ICST-AHMI/TPadTablet_design/pics/P4113149_C3.jpg

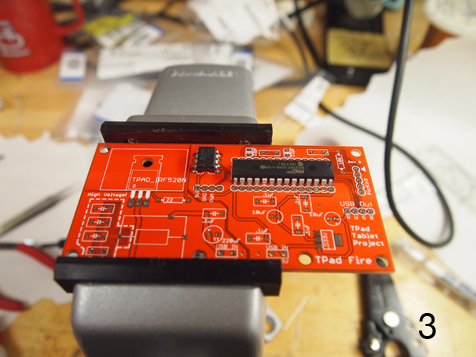
pics/P4113149_C3.jpg
