ICST-AHMI/TPadTablet_design/pics/P4113161_C14.jpg

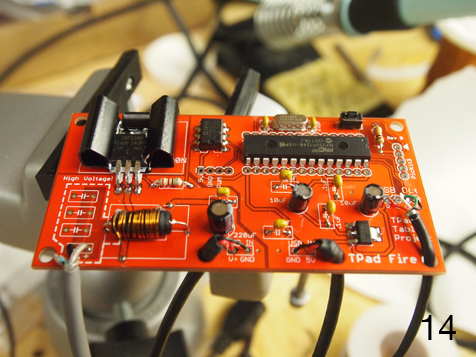
pics/P4113161_C14.jpg
