ICST-AHMI/TPadTablet_design/pics/first_C1.jpg

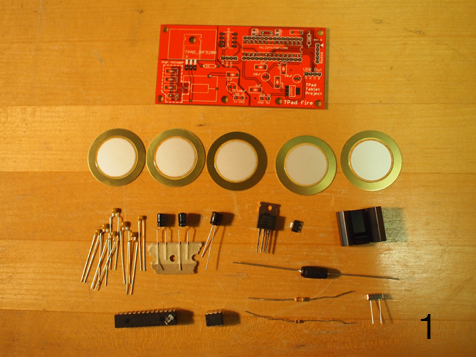
pics/first_C1.jpg
