ICST-AHMI/TPadTablet_design/pics/P4113148_C2.jpg

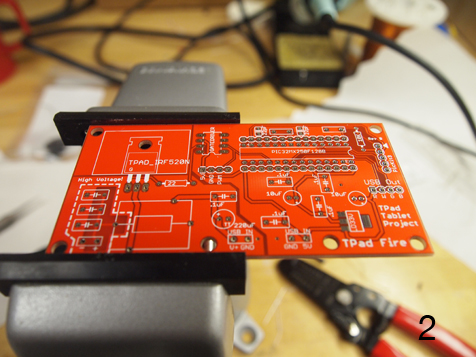
pics/P4113148_C2.jpg
