ICST-AHMI/TPadTablet_design/pics/P4113150_C4.jpg

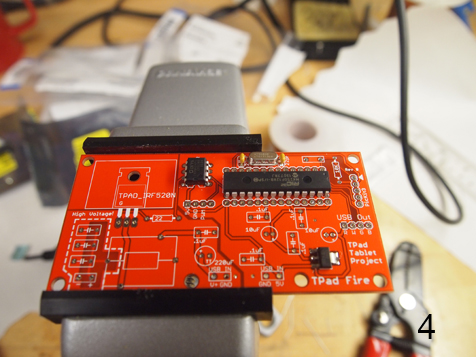
pics/P4113150_C4.jpg
