ICST-AHMI/TPadTablet_design/pics/P4113151_C5.jpg

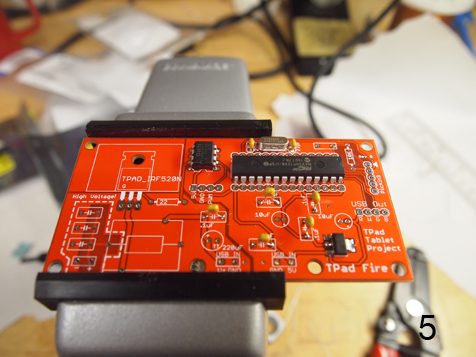
pics/P4113151_C5.jpg
