ICST-AHMI/TPadTablet_design/pics/P4113152_C6.jpg

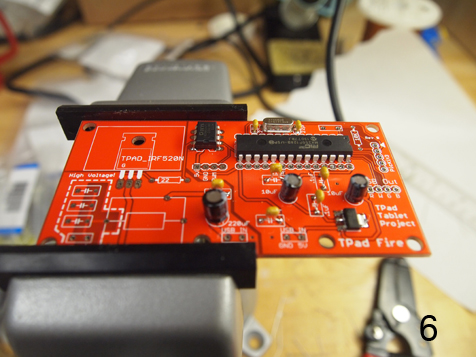
pics/P4113152_C6.jpg
