ICST-AHMI/TPadTablet_design/pics/P4113153_C7.jpg

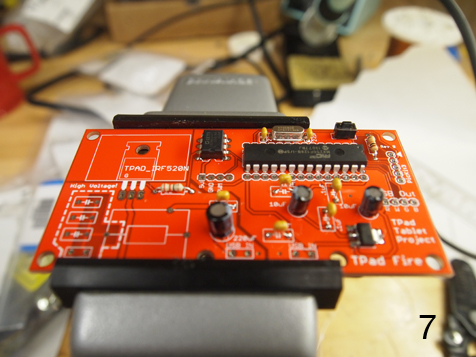
pics/P4113153_C7.jpg
