ICST-AHMI/TPadTablet_design/pics/P4113154_C8.jpg

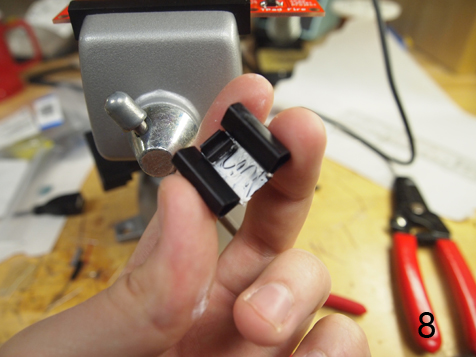
pics/P4113154_C8.jpg
