ICST-AHMI/TPadTablet_design/pics/P4113155_C9.jpg

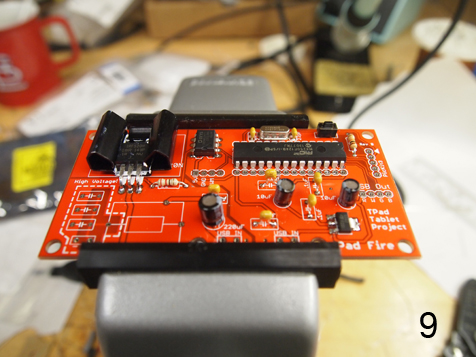
pics/P4113155_C9.jpg
