ICST-AHMI/TPadTablet_design/pics/P4113156_C10.jpg

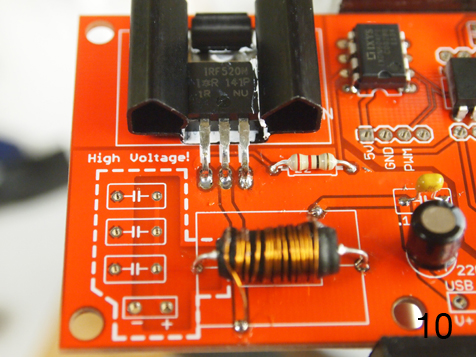
pics/P4113156_C10.jpg
