ICST-AHMI/TPadTablet_design/pics/P4113158_C11.jpg

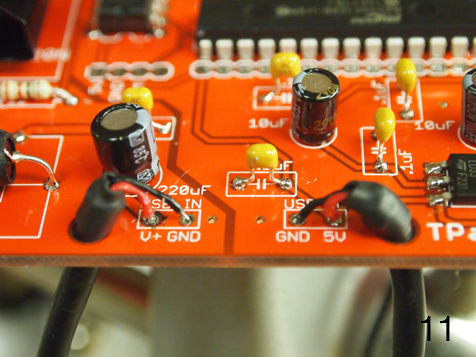
pics/P4113158_C11.jpg
