ICST-AHMI/TPadTablet_design/pics/P4113159_C12.jpg

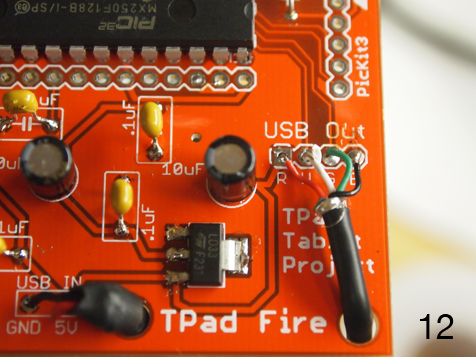
pics/P4113159_C12.jpg
