ICST-AHMI/TPadTablet_design/pics/P4113160_C13.jpg

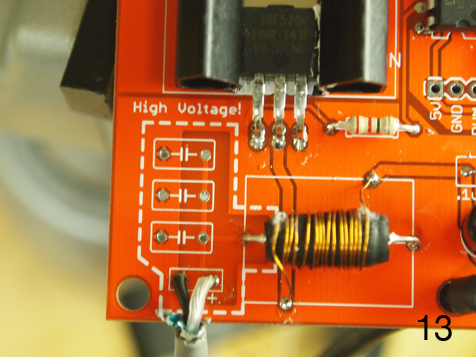
pics/P4113160_C13.jpg
