ICST-AHMI/TPadTablet_design/pics/P4113184_A1_1.jpg

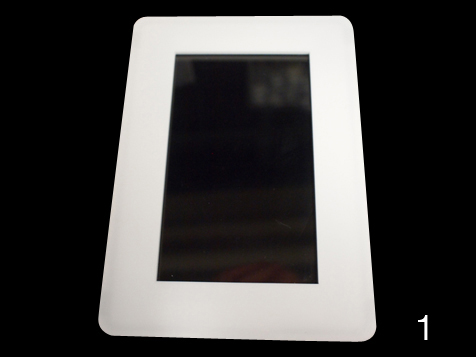
pics/P4113184_A1_1.jpg
