ICST-AHMI/TPadTablet_design/pics/P4113187_A2.jpg

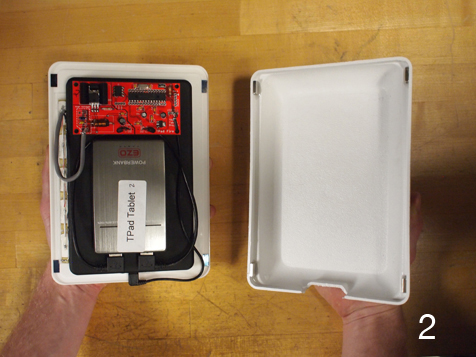
pics/P4113187_A2.jpg
