ICST-AHMI/TPadTablet_design/pics/P4113188_A3.jpg

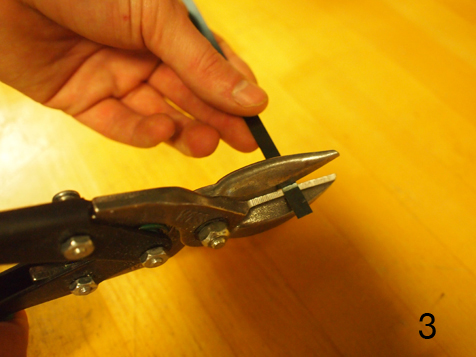
pics/P4113188_A3.jpg
