ICST-AHMI/TPadTablet_design/pics/P4113190_A4.jpg

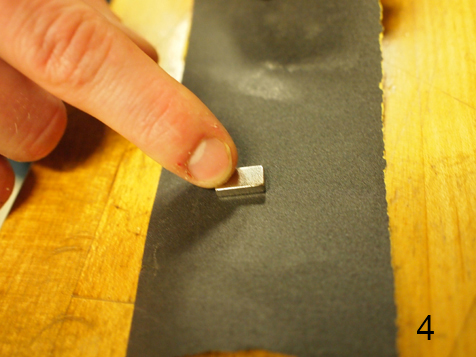
pics/P4113190_A4.jpg
