ICST-AHMI/TPadTablet_design/pics/P4113191_A6.jpg

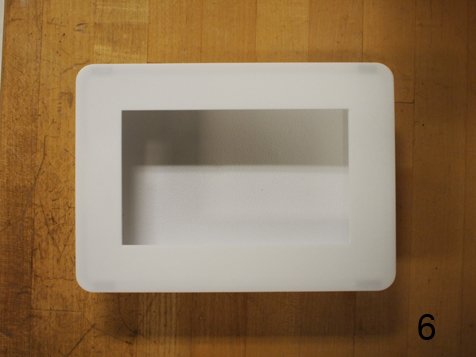
pics/P4113191_A6.jpg
