ICST-AHMI/TPadTablet_design/pics/P4113192_A5.jpg

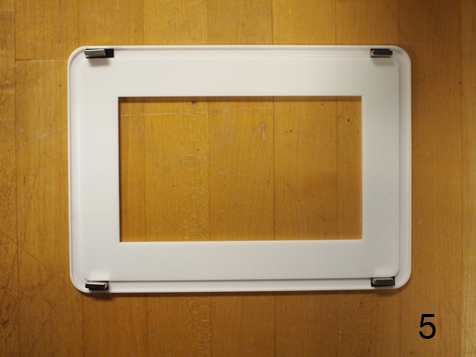
pics/P4113192_A5.jpg
