ICST-AHMI/TPadTablet_design/eagle/_export/bom/Bill of Materials - Electronics - 2.1.xlsx

Name (Description) | Ref Des | Manufacturer | Manufacturer P/N | Distributor | Qty | Price | Extended Price
LED SMARTLED GREEN 570NM 0603 | LED2 |  | LG L29K-G2J1-24-Z | Digi | 1 | 0.22 | 0.22
LED ORANGE 606NM 0603 SMD | LED1 |  | LO L29K-J2L1-24-Z | Digi | 1 | 0.21 | 0.21
LED SMARTLED RED 630NM 0603 SMD | LED3 |  | LS L29K-H1J2-1-Z | Digi | 1 | 0.21 | 0.21
IC LI-ION/LI-POLY CTRLR 10MSOP | U1 | Microchip | MCP73833-AMI/UN | Digi | 1 | 1.02 | 1.02
RES 330 OHM 1/8W 1% SMD 0603 | R1,R2,R3 | Vishay | MCT06030C3300FP500 | Digi | 3 | 0.08 | 0.24
RES 1.0K OHM 1/8W 5% 0805 SMD | R4 | Yageo | RC0805JR-071KL | Digi | 1 | 0.1 | 0.1
RES 10K OHM 1/10W 5% 0603 SMD | 3 | Samsung | RC1608J103CS | Digi | 1 | 0.1 | 0.1
RES 10K OHM 1/8W 5% 0805 SMD | R5 | Yageo | RC0805JR-0710KL | Digi | 1 | 0.1 | 0.1
CAP CER 10UF 10V 10% X5R 0805 | C1,C2 | Yageo | CC0805ZKY5V6BB106 | Digi | 2 | 0.19 | 0.38
CONN USB MICRO B RECPT SMT R/A | J2 | FCI | 10118193-0001LF | Digi | 1 | 0.46 | 0.46
IC DVR LOW SIDE OMINIFET SOT-223 | U2 | STM | VNL5050N3TR-E | Digi | 1 | 1.69 | 1.69
SW SLIDE DPDT 6VDC 0.3A PCMNT | S1 | C&K | JS202011CQN | Digi | 1 | 0.39 | 0.39
Li-Polymer 3.7V 5800mAh W/ PCB&Wires |  | Tenergy | 30130 | AllBattery | 1 | 27.5 | 27.5
CONN HEADER 2POS 4.2MM R/A TIN | J1 | Molex | 39300020 | Digi | 1 | 0.77 | 0.77
 |  |  |  |  |  | total | 32.62
DIODE SCHOTTKY 35V 8A POWERDI5 | D1 | Diodes, Inc | PDS835L-13 | Digi | 1 | 1.44 | 1.44
INDUCTOR POWER .82UH 19.0A SMD | L1 | Vishay Dale | IHLP3232DZERR82M01 | Digi | 1 | 1.48 | 1.48
MOSFET P-CH 20V 60A 8-SON | Q2 | TI | CSD25401Q3 | Digi | 1 | 1.32 | 1.32
MOSFET N-CH 25V 60A 8SON | Q1 | TI | CSD16340Q3 | Digi | 1 | 1.26 | 1.26
IC REG CTRLR PWN VM 16-TSSOP | U3 | TI | TPS43000PW | Digi | 1 | 6.13 | 6.13
RES 4.7 OHM 1/10W 5% 0603 SMD | R8, R9 | Yageo | RC0603JR-074R7L | Digi | 2 | 0.1 | 0.2
RES 10K OHM 1/10W 5% 0603 SMD | R11 | Samsung | RC1608J103CS | Digi | 1 | 0.1 | 0.1
RES 17.8K OHM 1/10W 1% 0603 SMD | R13 | Yageo | RC0603FR-0717K8L | Digi | 1 | 0.1 | 0.1
RES 19.1K OHM 1/10W 1% 0603 SMD | R12 | Yageo | RC0603FR-0719K1L | Digi | 1 | 0.1 | 0.1
RES 63.4K OHM 1/10W 1% 0603 SMD | R14 | Yageo | RC0603FR-0763K4L | Digi | 1 | 0.1 | 0.1
RES 100K OHM 1/10W 5% 0603 SMD | R10 | Yageo | RC0603JR-07100KL | Digi | 1 | 0.1 | 0.1
RES 1.0K OHM 1/10W 5% 0603 SMD | R7 | Yageo | RC0603JR-071KL | Digi | 1 | 0.1 | 0.1
CAP TANT 330UF 6.3V 20% 2917 | C4,C5 | Panasonic | 6TPE330ML | Digi | 2 | 2.03 | 4.06
CAP CER 47UF 10V Y5V 1210 | C6,C7 | TDK | C3225Y5V1A476Z | Digi | 2 | 0.94 | 1.88
CAP CER 10UF 10V Y5V 0805 | C8 | Yageo | CC0805ZKY5V6BB106 | Digi | 1 | 0.16 | 0.16
CAP CER 4700PF 50V 10% X7R 0603 | C3,C9 | TDK | C1608X7R1H472K | Digi | 2 | 0.1 | 0.2
CAP CER 0.47UF 10V 10% X5R 0603 | C10,C11,C12 | TDK | C1608X5R1A474K080AA | Digi | 3 | 0.1 | 0.3
CAP CER 220PF 50V 5% NP0 0603 | C13 | Samsung | CL10C221JB8NCNC | Digi | 1 | 0.1 | 0.1
CAP CER 1500PF 50V 10% X7R 0603 | C14 | Samsung | CL10B152KB8SFNC | Digi | 1 | 0.1 | 0.1
CAP CER 27PF 50V 5% NP0 0603 | C15 | Samsung | CL10C270JB8NNNC | Digi | 1 | 0.1 | 0.1
CAP CER 2.2UF 6.3V Y5V 0603 |  | Yageo | CC0603ZRY5V5BB225 | Digi | 4 | 0.11 | 0.44
 |  |  |  |  |  | total | 19.77
CONN PLUG USB 4POS RT ANG PCB | J4 | Molex | 480370001 | Digi | 1 | 1.19 | 1.19
CONN POWER JACK 2.1MM PCB | J3 | CUI | PJ-202A | Digi | 1 | 0.92 | 0.92
IC MOSFET DVR 1.5A HS SOT23-5 | U5 | Microchip | MCP1416T-E/OT | Digi | 1 | 0.74 | 0.74
CAP CER 0.1UF 25V Y5V 0603 | C16, C17, C18, C19, C21, C26, C39 | Samsung | CL10F104ZA8NNNC | Digi | 7 | 0.1 | 0.7
CAP CER 0.47UF 10V 10% X5R 0603 | C28, C29, C31, C32, C34, C35, C37, C38, | TDK | C1608X5R1A474K080AA | Digi | 8 | 0.1 | 0.8
CAP CER 10UF 10V Y5V 0805 | C20, C23 | Yageo | CC0805ZKY5V6BB106 | Digi | 1 | 0.16 | 0.16
IC REG LDO 3.3V 0.95A SOT223 | N/A | STMicro | LD1117S33CTR | Digi | 1 | 0.54 | 0.54
RES 330 OHM 1/8W 1% SMD 0603 | R16, R17, R28 | Vishay | MCT06030C3300FP500 | Digi | 3 | 0.08 | 0.24
RES 22 OHM 1/10W 5% 0603 SMD | R15 | Yageo | RC0603JR-0722RL | Digi | 1 | 0.1 | 0.1
RES 10K OHM 1/10W 5% 0603 SMD | R18, R27 | Yageo | RC0603JR-0710KL | Digi | 2 | 0.1 | 0.2
RES 1.5K OHM 1/10W 5% 0603 SMD | R19, R20, R21, R22, R23, R24, R25, R26 | Yageo | RC0603JR-071K5L | Digi | 8 | 0.1 | 0.8
LED SMARTLED GREEN 570NM 0603 | LED5 | LG | LG L29K-G2J1-24-Z | Digi | 1 | 0.22 | 0.22
LED ORANGE 606NM 0603 SMD | LED4 |  | LO L29K-J2L1-24-Z | Digi | 1 | 0.21 | 0.21
IC MCU 16BIT 256KB FLASH 64TQFP | U4 | Microchip | PIC24FJ256GB206-I/PT | Digi | 1 | 7.68 | 7.68
IC AMP AUDIO PWR 1.6W 14ETSSOP | U6, U7, U8, U9 | Texas Instruments | LM48100QMH/NOPB | Digi | 4 | 2.83 | 11.32
HEATSINK TO-220 SNAP-DOWN .75" | N/A | Aavid Thermalloy | 579302B00000G | Digi | 1 | 0.84 | 0.84
CHOKE RF HI CURRENT 390UH .400A | N/A | Bourns Inc | 5800-391-RC | Digi | 1 | 0.87 | 0.87
MOSFET N-CH 30V 27A TO220 | N/A | STMicro | STP27N3LH5 | Digi | 1 | 1 | 1
 |  |  |  |  |  | Total | 27.34
 |  |  |  |  |  | All Total | 79.73
