ICST-AHMI/TPadTablet_design/eagle/_export/bom/TPadTabletBattery_BOM_160211.xlsx

BILL OF MATERIAL FROM TEST_WIDERSTAENDE_AUS_RCL.SCH, 29 PARTS, GROUPED BY VALUES, AS OF 05.10.2010 16:00:00
Part | Value | Device | Package | Description | Description2 | Qty | Place_YES/NO | Povided_by_customer_YES/NO | Distributor | Ordernumber | Weblink | Remarks_customer | Unit_price | Total_price | REMARKS_BETA | OPTION1 | OPTION2 | OPTION3
C1, C2, C8, C20, C23, C40, C41, C42, C43 | 10uF | C-EUC0805 | C0805 | CAPACITOR, European symbol | Capacitor, 0805, 10uF, 16V | 9 | YES | NO | Beta | 6911161P | http://uk.rs-online.com/web/search/searchBrowseAction.html?method=searchProducts&searchTerm=6911161P&x=0&y=0 |  |  | #VALUE!
C3, C9 | 4700pF | C-EUC0603 | C0603 | CAPACITOR, European symbol |  | 2 | YES | NO | Digikey | 445-173690-1-ND | http://www.digikey.ch/product-detail/de/C1608X7R1H472K080AE/445-173690-1-ND/5809761 |  | 0.09 | 0.18
C4, C5 | 330uF | CPOL-EUC/6032-28R | C/6032-28R | POLARIZED CAPACITOR, European symbol |  | 2 | YES | NO | Digikey | 478-4773-1-ND | http://www.digikey.ch/product-detail/de/TAJC337K006RNJ/478-4773-1-ND/1833865 |  |  | #VALUE!
C6, C7, C48 | 47uF | C-EUC1210 | C1210 | CAPACITOR, European symbol |  | 3 | YES | NO | Digikey | 490-5312-1-ND | http://www.digikey.ch/product-detail/de/GRM32ER71A476KE15L/490-5312-1-ND/2039091 |  |  | #VALUE!
C10, C11, C12, C28, C29, C31, C32, C34, C35, C37, C38 | 0.47uF | C-EUC0603 | C0603 | CAPACITOR, European symbol |  | 11 | YES | NO | Digikey | 445-1320-1-ND | http://www.digikey.ch/product-detail/de/C1608X5R1A474K080AA/445-1320-1-ND/567693 |  |  | #VALUE!
C13 | 220pF | C-EUC0603 | C0603 | CAPACITOR, European symbol |  | 1 | YES | NO | Digikey | 1276-2234-1-ND | http://www.digikey.ch/product-detail/de/CL10C221JB8NCNC/1276-2234-1-ND/3890320 |  |  | #VALUE!
C14 | 1500pF | C-EUC0603 | C0603 | CAPACITOR, European symbol |  | 1 | YES | NO | Digikey | 1276-1960-1-ND | http://www.digikey.ch/product-detail/de/CL10B152KB8SFNC/1276-1960-1-ND/3890046 |  |  | #VALUE!
C15 | 27pF | C-EUC0603 | C0603 | CAPACITOR, European symbol |  | 1 | YES | NO | Digikey | 1276-2245-1-ND | http://www.digikey.ch/product-detail/de/CL10C270FB8NNNC/1276-2245-1-ND/3890331 |  |  | #VALUE!
C16, C17, C18, C19, C21, C26, C39, C44, C45, C46, C47 | 0.1uF | C-EUC0603 | C0603 | CAPACITOR, European symbol |  | 11 | YES | NO | Digikey | 1276-1061-1-ND | http://www.digikey.ch/product-detail/de/CL10B104JO8NNNC/1276-1061-1-ND/3889147 |  |  | #VALUE!
C22, C24, C25 | 10nF | C-US050-035X075 | C050-035X075 | CAPACITOR, American symbol |  | 3 | NO | NO | Digikey |  |  |  |  | #VALUE!
 | 3.3nF |  |  |  |  |  | NO | NO | Digikey
 |  |  |  |  |  |  | NO | NO | Digikey
C27, C30, C33, C36 | 2.2uF | C-EUC0603 | C0603 | CAPACITOR, European symbol |  | 4 | YES | NO | Digikey | 311-1452-1-ND | http://www.digikey.ch/product-detail/de/CC0603ZRY5V5BB225/311-1452-1-ND/2833758 |  |  | #VALUE!
D1 |  | POWER-DIODE_PDS835L | POWER-DIODE_PDS835L |  |  | 1 | YES | NO | Digikey | PDS835LDICT-ND | http://www.digikey.ch/product-detail/de/PDS835L-13/PDS835LDICT-ND/717937 |  |  | 0
DRV |  | VNL5050 | SOT-223 |  |  | 1 | YES | NO | Digikey | 497-11709-1-ND | http://www.digikey.ch/product-detail/de/VNL5050N3TR-E/497-11709-1-ND/2746938 |  |  | 0
J1 | MOLEX-MINI-FIT-JR-2POS-RA | MOLEX-MINI-FIT-JR-2POS-RA | MOLEX-MINI-FIT-JR-2POS-RA |  |  | 1 | NO | NO | Digikey | WM1351-ND | http://www.digikey.ch/product-detail/de/0039301020/WM1351-ND/561078 |  |  | #VALUE!
J2 | USB MICRO-B | USB_MICROAMPHENOL_10118193-0001LFMICRO-B | USB-MICROB_SMD |  |  | 1 | YES | NO | Digikey | 609-4616-1-ND | http://www.digikey.ch/product-detail/de/10118193-0001LF/609-4616-1-ND/2785380 |  | 0.42 | 0.42
JP1, JP10, JP14 | 0.1 6POS" | M06SIP | 1X06 | Header 6 |  | 3 | NO | NO | ICST |  |  |  |  | #VALUE!
JP2 | 0.1 2POS" | MICROBUILDER_HEADER-1X2ROUND | MICROBUILDER_1X02_ROUND | PIN HEADER |  | 1 | NO | NO | ICST |  |  |  |  | #VALUE!
JP3, JP4, JP5, JP6, JP8 | 0.1 3POS" | M03PTH | 1X03 | Header 3 |  | 5 | NO | NO | ICST |  |  |  |  | #VALUE!
JP7, JP9, JP11, JP12, JP13 | 0.15 2POS" | M02PTH2 | 1X02_BIG | Header 2 |  | 5 | NO | NO |  |  |  |  |  | #VALUE!
L1 | .82uH | .82UH_INDUCTOR-IHLP3232DZERR82M01 | .82UH_INDUCTOR-IHLP3232DZERR82M01 |  |  | 1 | YES | NO | Digikey | 541-1382-1-ND | http://www.digikey.ch/product-detail/de/IHLP3232DZERR82M01/541-1382-1-ND/2657491 |  |  | #VALUE!
LDO | LDO | LDO | SOT-223 |  |  | 1 | YES | NO | Digikey | 497-1241-1-ND | http://www.digikey.ch/product-detail/de/LD1117S33CTR/497-1241-1-ND/586241 |  |  | #VALUE!
LED1, LED4 | ORANGE | MICROBUILDER_LED0603 | MICROBUILDER_CHIPLED_0603 | LED |  | 2 | YES | NO | Digikey | 160-1477-1-ND | http://www.digikey.ch/product-detail/de/LTST-S270KFKT/160-1477-1-ND/386890 |  |  | #VALUE!
LED2, LED5 | GREEN | MICROBUILDER_LED0603 | MICROBUILDER_CHIPLED_0603 | LED |  | 2 | YES | NO | Digikey | 160-1478-1-ND | http://www.digikey.ch/product-detail/de/LTST-S270KGKT/160-1478-1-ND/386892 |  |  | #VALUE!
LED3 | RED | MICROBUILDER_LED0603 | MICROBUILDER_CHIPLED_0603 | LED |  | 1 | YES | NO | Digikey | 160-1479-1-ND | http://www.digikey.ch/product-detail/de/LTST-S270KRKT/160-1479-1-ND/386894 |  |  | #VALUE!
LED6, LED7, LED8, LED9 | YELLOW | MICROBUILDER_LED0603 | MICROBUILDER_CHIPLED_0603 | LED |  | 4 | YES | NO | Digikey | 160-1480-1-ND | http://www.digikey.ch/product-detail/de/LTST-S270KSKT/160-1480-1-ND/386896 |  |  | #VALUE!
PICKIT3 | 0.1 5POS" | M05PTH | 1X05 | Header 5 |  | 1 | NO | NO | ICST |  |  |  |  | #VALUE!
PWR | LUMBERG-1613-14",LUMBERG-1613-14"" | LUMBERG-1613_14 |  |  | 1 |  | NO | NO | ICST |  |  |  |  | #VALUE!
Q1 | CSD16340Q3 | CSD16340Q3 | CSDXXXXQ3 |  |  | 1 | YES | NO | Digikey | 296-25646-1-ND | http://www.digikey.ch/product-detail/de/CSD16340Q3/296-25646-1-ND/2202572 |  |  | #VALUE!
Q2 | CSD25402Q3A | CSD25402Q3A | CSDXXXXQ3 |  |  | 1 | YES | NO | Digikey | 296-38916-1-ND | http://www.digikey.ch/product-detail/de/CSD25402Q3A/296-38916-1-ND/5143022 |  |  | #VALUE!
Q3 | STP27N3LH5 | TPAD_IRF520N | TPAD_TO220 |  |  | 1 | NO | NO | Digikey | 497-9095-5-ND | http://www.digikey.ch/product-detail/de/STP27N3LH5/497-9095-5-ND/2136055 |  |  | #VALUE!
R1, R2, R3, R16, R17, R28 | 330 | R-EU_R0603 | R0603 | RESISTOR, European symbol | RESISTOR, 0.1W, 1% | 6 | YES | NO | Beta | 6979202 | http://uk.rs-online.com/web/search/searchBrowseAction.html?method=getProduct&R=6979202 |  |  | #VALUE!
R4 | 1K | R-EU_R0805 | R0805 | RESISTOR, European symbol | RESISTOR, 0.125W, 1% | 1 | YES | NO | Beta | 6980075 | http://uk.rs-online.com/web/search/searchBrowseAction.html?method=getProduct&R=6980075 |  |  | #VALUE!
R5 | 10k | R-EU_R0805 | R0805 | RESISTOR, European symbol | RESISTOR, 0.125W, 1% | 1 | YES | NO | Beta | 6980154 | http://uk.rs-online.com/web/search/searchBrowseAction.html?method=getProduct&R=6980154 |  |  | #VALUE!
R6, R11, R18, R27 | 10K | R-EU_R0603 | R0603 | RESISTOR, European symbol | RESISTOR, 0.1W, 1% | 4 | YES | NO | Beta | 6979325 | http://uk.rs-online.com/web/search/searchBrowseAction.html?method=getProduct&R=6979325 |  |  | #VALUE!
R7 | 1K | R-EU_R0603 | R0603 | RESISTOR, European symbol | RESISTOR, 0.1W, 1% | 1 | YES | NO | Beta | 6979246 | http://uk.rs-online.com/web/search/searchBrowseAction.html?method=getProduct&R=6979246 |  |  | #VALUE!
R8, R9 | 4.7 | R-EU_R0603 | R0603 | RESISTOR, European symbol |  | 2 | YES | NO | Digikey | P17385CT-ND | http://www.digikey.ch/product-detail/de/ERJ-3BQF4R7V/P17385CT-ND/5647869 |  |  | #VALUE!
R10 | 100K | R-EU_R0603 | R0603 | RESISTOR, European symbol | RESISTOR, 0.1W, 1% | 1 | YES | NO | Beta | 697-9438 | http://de.rs-online.com/web/p/products/6979438/?searchTerm=697-9438 |  |  | #VALUE!
R12 | 19.1K | R-EU_R0603 | R0603 | RESISTOR, European symbol |  | 1 | YES | NO | Digikey | 311-19.1KHRCT-ND | http://www.digikey.ch/product-detail/de/RC0603FR-0719K1L/311-19.1KHRCT-ND/729948 |  |  | #VALUE!
R13 | 17.8K | R-EU_R0603 | R0603 | RESISTOR, European symbol |  | 1 | YES | NO | Digikey | 311-17.8KHRCT-ND | http://www.digikey.ch/product-detail/de/RC0603FR-0717K8L/311-17.8KHRCT-ND/729930 |  |  | #VALUE!
R14 | 63.4K | R-EU_R0603 | R0603 | RESISTOR, European symbol |  | 1 | YES | NO | Digikey | 311-63.4KHRCT-ND | http://www.digikey.ch/product-detail/de/RC0603FR-0763K4L/311-63.4KHRCT-ND/730287 |  |  | #VALUE!
R15 | 22 | R-EU_R0603 | R0603 | RESISTOR, European symbol | RESISTOR, 0.1W, 1% | 1 | YES | NO | Beta | 6979113 | http://uk.rs-online.com/web/search/searchBrowseAction.html?method=getProduct&R=6979113 |  |  | #VALUE!
R19, R20, R21, R22, R23, R24, R25, R26 | 1.5k | R-EU_R0603 | R0603 | RESISTOR, European symbol | RESISTOR, 0.1W, 1% | 8 | YES | NO | Beta | 6979261 | http://uk.rs-online.com/web/search/searchBrowseAction.html?method=getProduct&R=6979261 |  |  | #VALUE!
SW1 | SLIDE_SWITCH-JS202011CQN | SLIDE_SWITCH-JS202011CQN | SLIDE_SWITCH-JS202011CQN |  |  | 1 | NO | NO | Digikey | 401-2001-ND | http://www.digikey.ch/product-detail/de/JS202011CQN/401-2001-ND/1640097 |  |  | #VALUE!
U$1 | USB A | USBSOCKET-THT | USB-A_SOCKET-THT |  |  | 1 | NO | NO | Digikey | AE11191-ND | http://www.digikey.ch/product-detail/de/AU-Y1005-2/AE11191-ND/5031760 |  |  | #VALUE!
U$4 | TRANSFORMER | TRANSFORMER | TRANSFORMER |  |  | 1 | NO | NO | Digikey | M8297-ND | http://www.digikey.ch/product-search/de?keywords=5800-391-RC |  |  | #VALUE!
U1 | MCP73833-AMI/UN | MICROBUILDER_MCP73833 | MICROBUILDER_MSOP10 | Lithium-Polymer/Lithium-Ion Battery Charger [Part No.] |  | 1 | YES | NO | Digikey | MCP73833-AMI/UN-ND | http://www.digikey.ch/product-detail/de/MCP73833-AMI%2FUN/MCP73833-AMI%2FUN-ND/1223157 |  |  | #VALUE!
U3 |  | TPS43000 | TSSOP16 |  |  | 1 | YES | NO | Digikey | 296-41744-1-ND | http://www.digikey.ch/product-detail/de/TPS43000PWR/296-41744-1-ND/5224509 |  |  | 0
U4 | PIC24FJ256GB206 | PIC24FXXXDAX06 | PIC24FXXX_TQFP64 | PIC24FXXXDAX06 |  | 1 | YES | NO | Digikey | PIC24FJ256GB206T-I/PTCT-ND | http://www.digikey.ch/product-detail/de/PIC24FJ256GB206T-I%2FPT/PIC24FJ256GB206T-I%2FPTCT-ND/5358262 |  | 5.89 | 5.89
U5 | MICROCHIP-MINI-DRIVER-MCP1416T-E/OT | MICROCHIP-MINI-DRIVER-MCP1416T-E/OT | MICROCHIP-MINI-DRIVER-MCP1416T-E/OT |  |  | 1 | YES | NO | Digikey | MCP1416T-E/OTCT-ND | http://www.digikey.ch/product-detail/de/MCP1416T-E%2FOT/MCP1416T-E%2FOTCT-ND/1963940 |  |  | 0
U6, U7, U8, U9 |  | LM48100Q | LM48100 |  |  | 4 | YES | NO | Digikey | LM48100QMHE/NOPBDKR-ND | http://www.digikey.ch/product-detail/de/LM48100QMHE%2FNOPB/LM48100QMHE%2FNOPBDKR-ND/1982195 |  | 2.9 | 11.6
SUPPLEMENTARY PARTS NOT LISTED IN THE EAGLE DOCUMENT
Part | Value | Device | Package | Descritption | Description2 | Qty | Place_YES/NO | Provided | Distributor | Ordernumber | Weblink | Remarks_customer | Unit_price | Total_price
HEATSINK TO-220 SNAP-DOWN .75" | N/A | Aavid Thermalloy | 579302B00000G |  |  | 1 | NO | NO | Digikey | HS220-ND | http://www.digikey.ch/product-detail/de/579302B00000G/HS220-ND/240985 |  | 0.64 | 0.64
USB cable A - micro B RA | N/A | Tripp Lite | UR050-003-RA | Reversible A plug |  | 2 | NO | NO | Amazon | B00ESZIIRU | http://www.amazon.com/Tripp-Lite-Universal-Reversible-UR050-003-RA/dp/B00ESZIIRU |  | 8.77 | 17.54
USB cable A RA - micro B | N/A | kenable |  |  |  | 3 | NO | NO | Amazon | B00KQUZFW2 | http://www.amazon.com/kenable-RIGHT-ANGLE-MICRO-Charging/dp/B00KQUZFW2 |  | 2.98 | 8.94
ASUS Nexus 7 | 7", 32 GB | ASUS |  | Old device with Android 4.1 (Jelly Bean) |  | 1 | NO | NO | Amazon | B00AK7OEBE | http://www.amazon.com/ASUS-Nexus-ASUS-1B32-4G-7-Inch-Tablet/dp/B00AK7OEBE |  | 227.64 | 227.64
