ICST-AHMI/TPadTablet_design/blender/orig_files/Version 2, 31mm topplate.sldprt

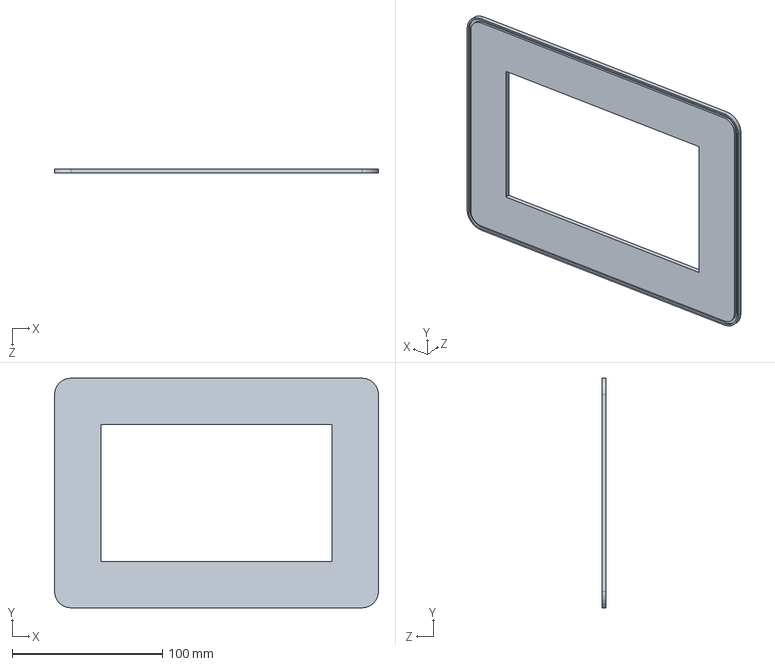
[picture p21: CAD file, 2016-03-23]
blender/orig_files/Version 2, 31mm topplate.sldprt
216.0 x 153.2 x 2.90 mm
