ICST-AHMI/TPadTablet_design/blender/orig_files/magnet lip on sides.sldprt

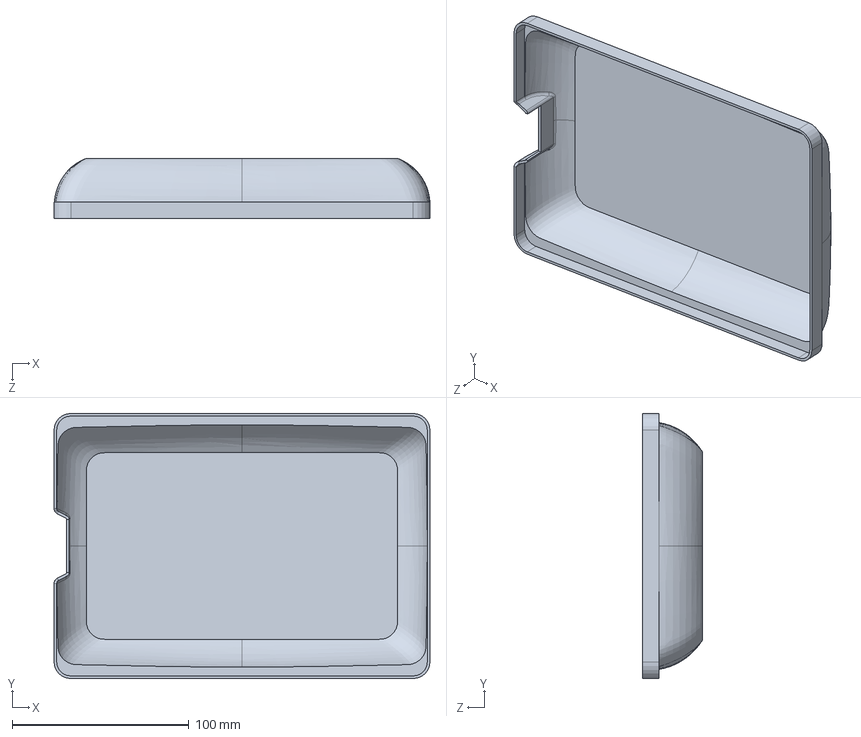
[picture p22: CAD file, 2016-03-23]
blender/orig_files/magnet lip on sides.sldprt
213.0 x 150.2 x 34.0 mm
