ICST-AHMI/TPadTablet_design/(list of files, cad)

Other CAD files:
blender/orig_files/Version 2, 31mm topplate.STL
blender/orig_files/magnet lip on sides.STL
blender/tPadTablet_V01.blend
