ICST-AHMI/TPadTablet_design/eagle/TPadTabletBattery_placement-BOT.pdf

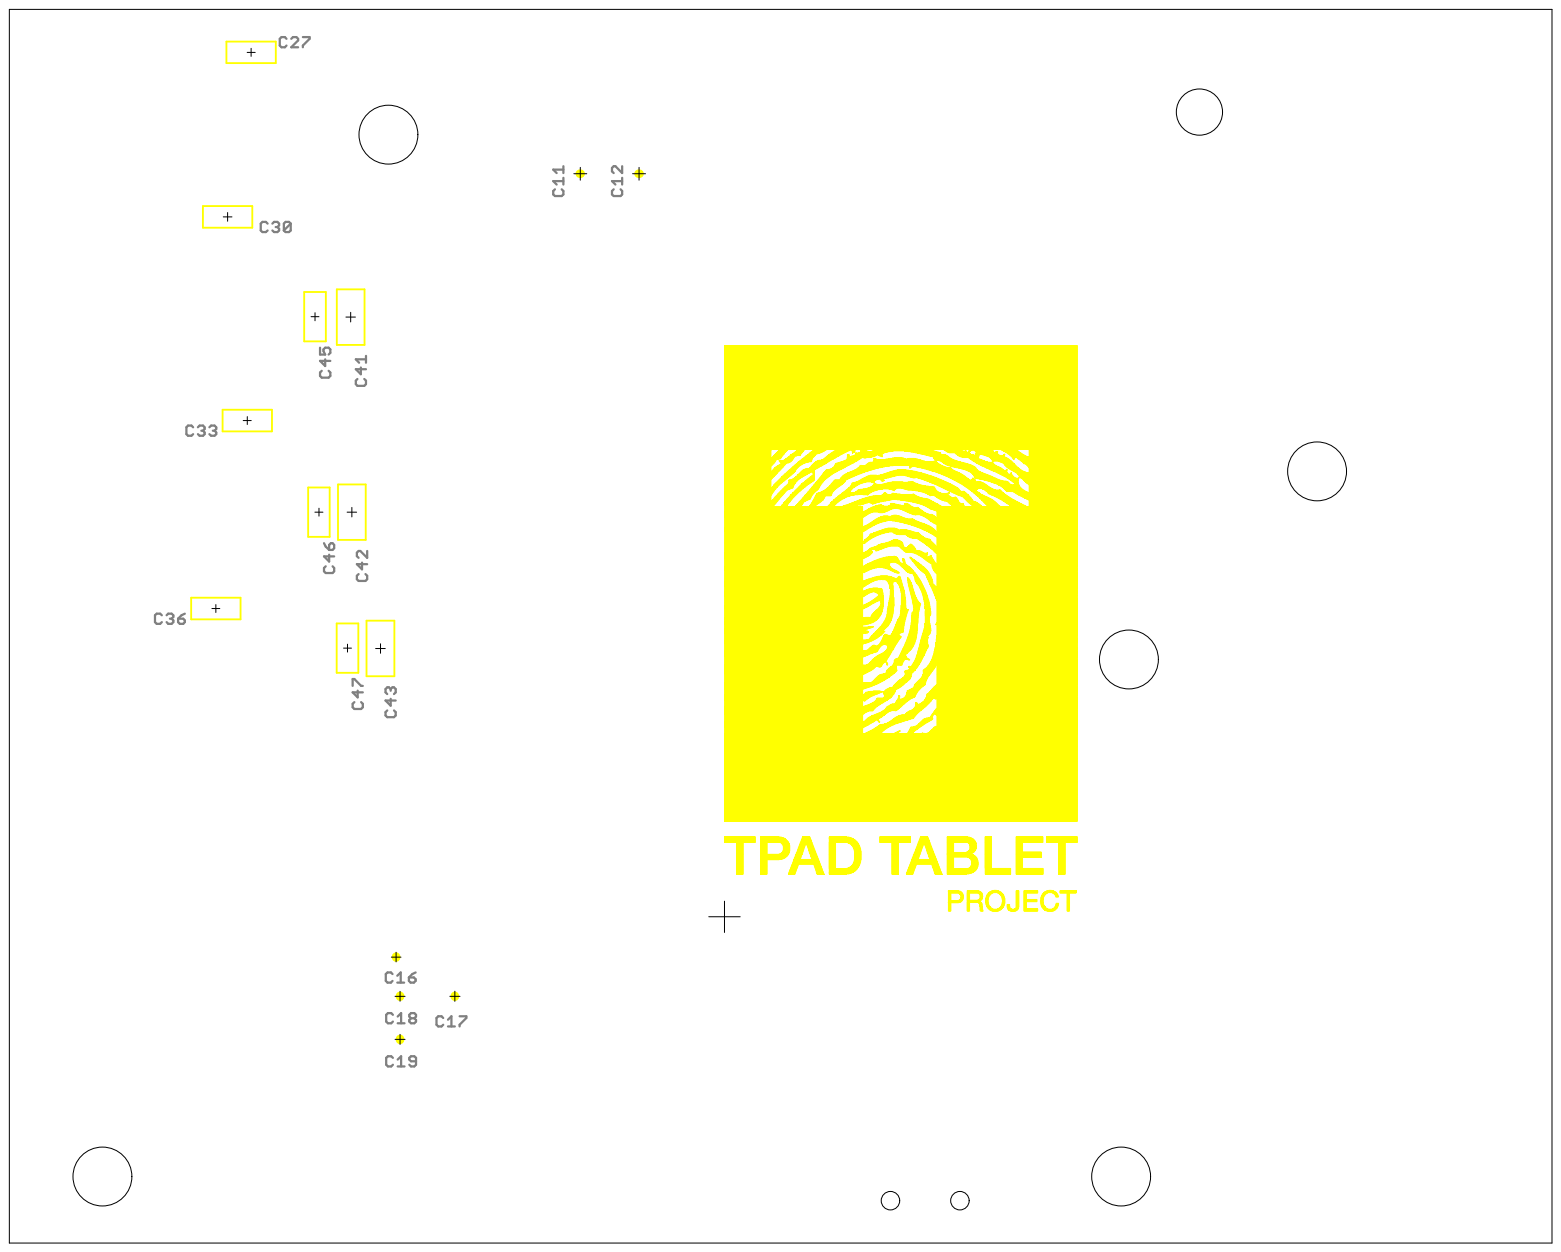
[picture p23: page 1]
