ICST-AHMI/TPadTablet_design/eagle/TPadTabletBattery_placement-TOP.pdf

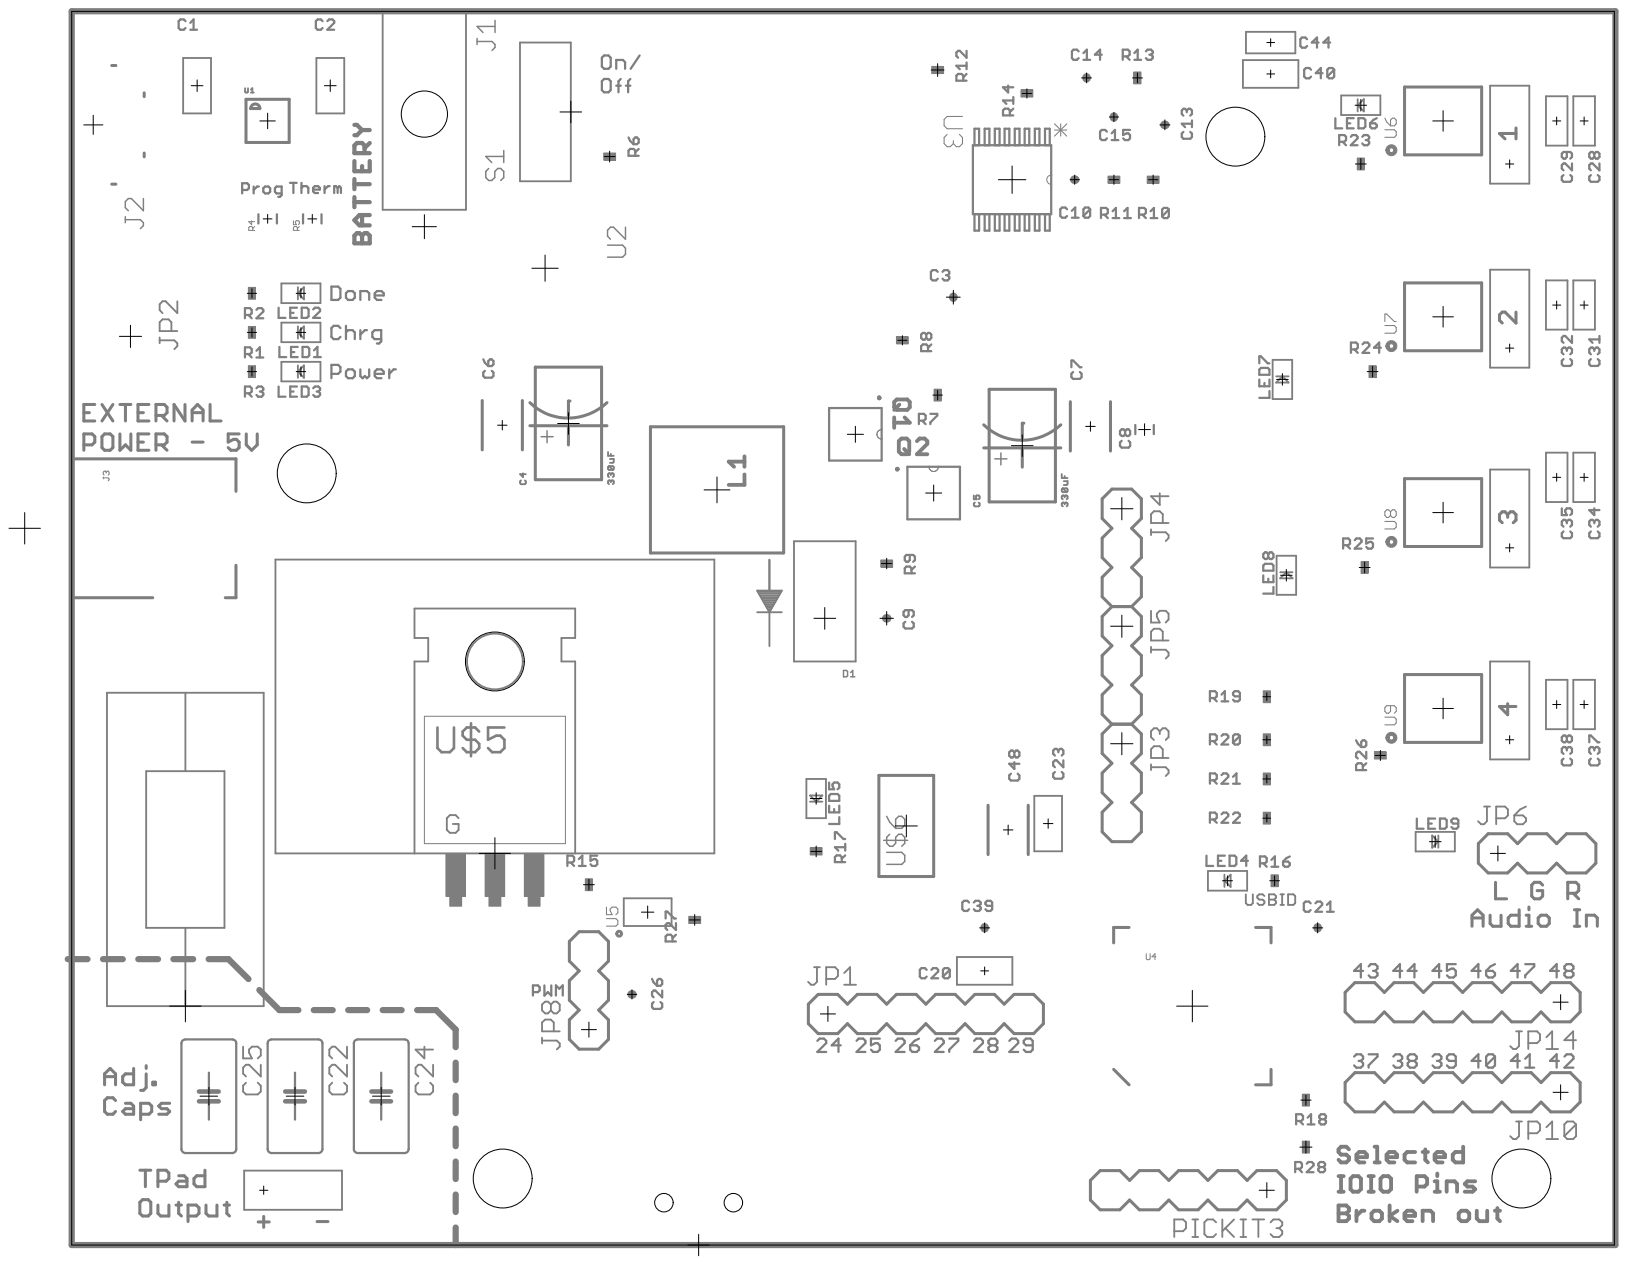
[picture p24: page 1]
