ICST-AHMI/TPadTablet_design/eagle/_export/gerber/Beta-Layout_Layers.pdf

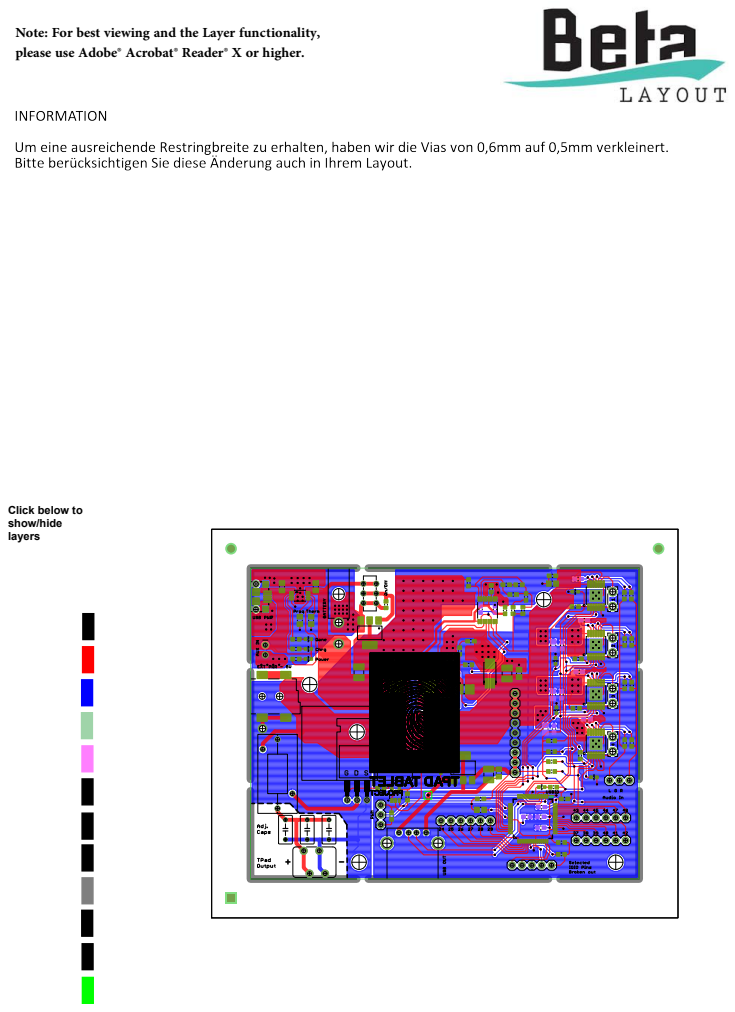
[picture p25: page 1]

Note: For best viewing and the Layer functionality,
please use Adobe® Acrobat® Reader® X or higher.
