ICST-AHMI/TPadTablet_design/eagle/_export/pdf/TPadTabletBattery_Bestueckung_BOT.pdf

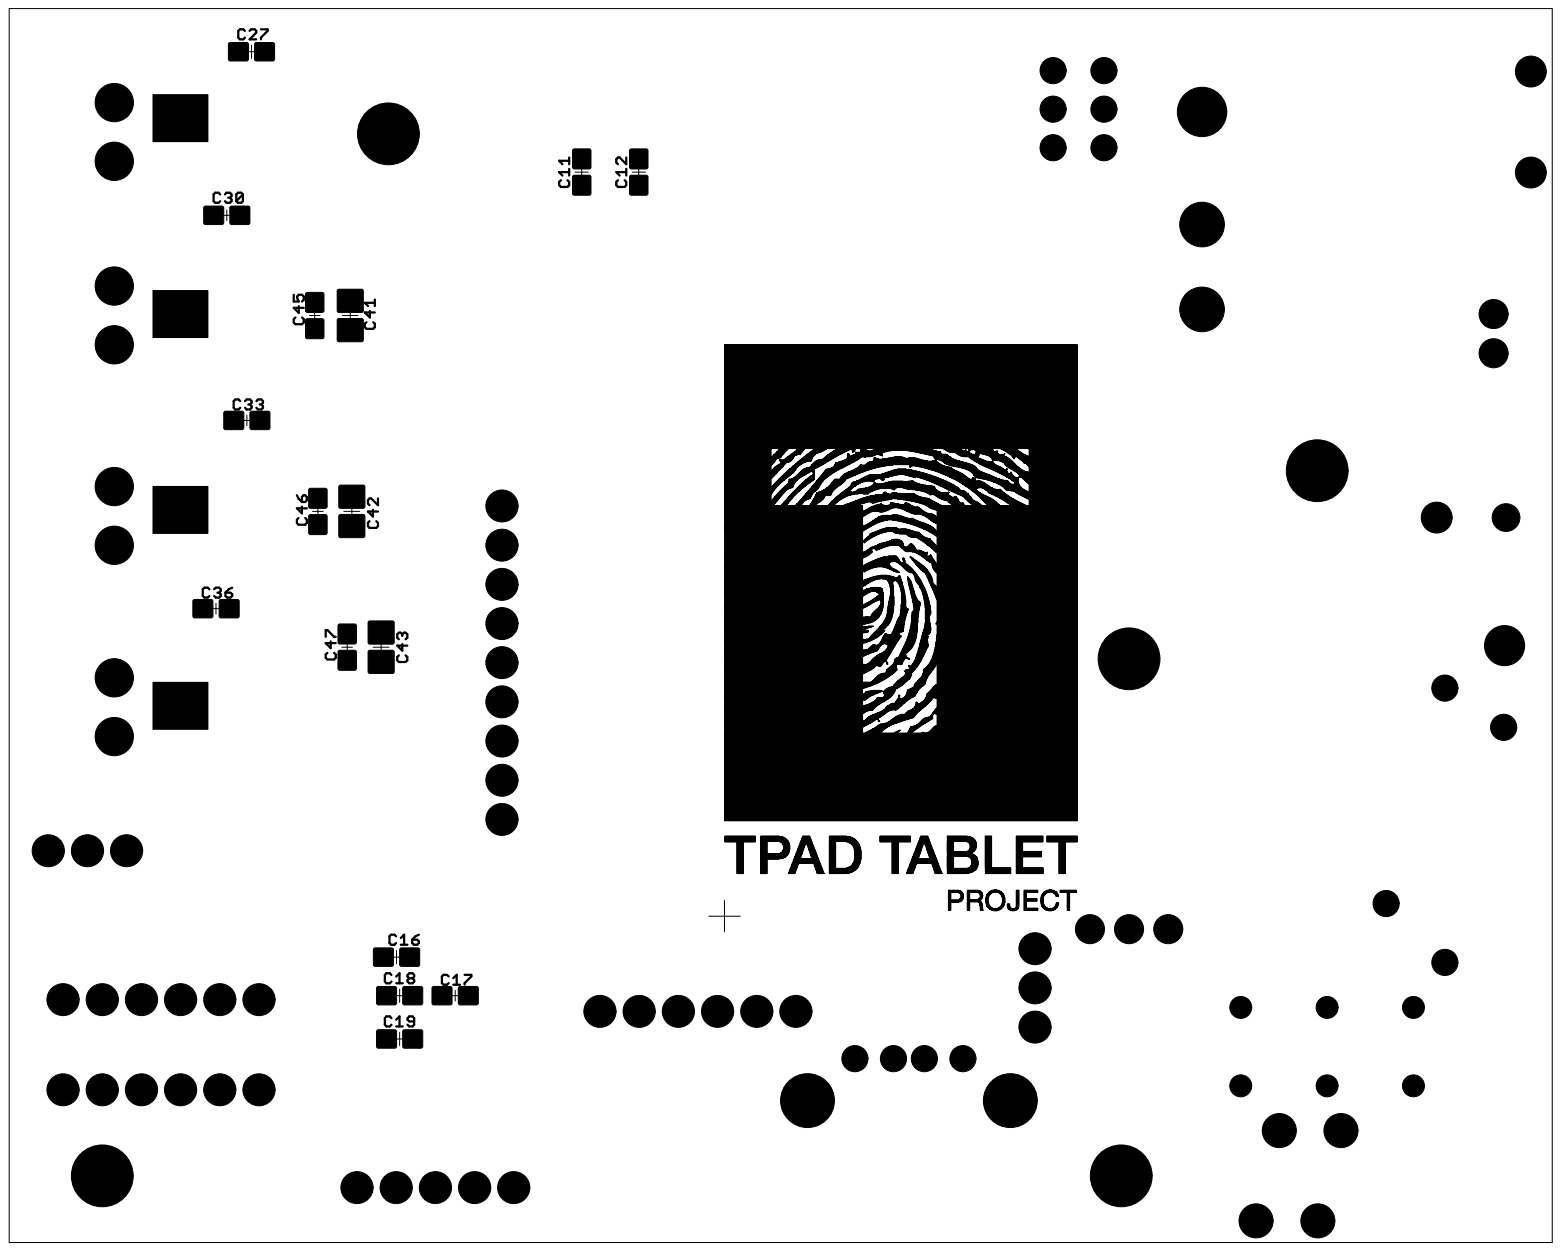
[picture p26: page 1]
