ICST-AHMI/TPadTablet_design/eagle/_export/pdf/TPadTabletBattery_Bestueckung_TOP.pdf

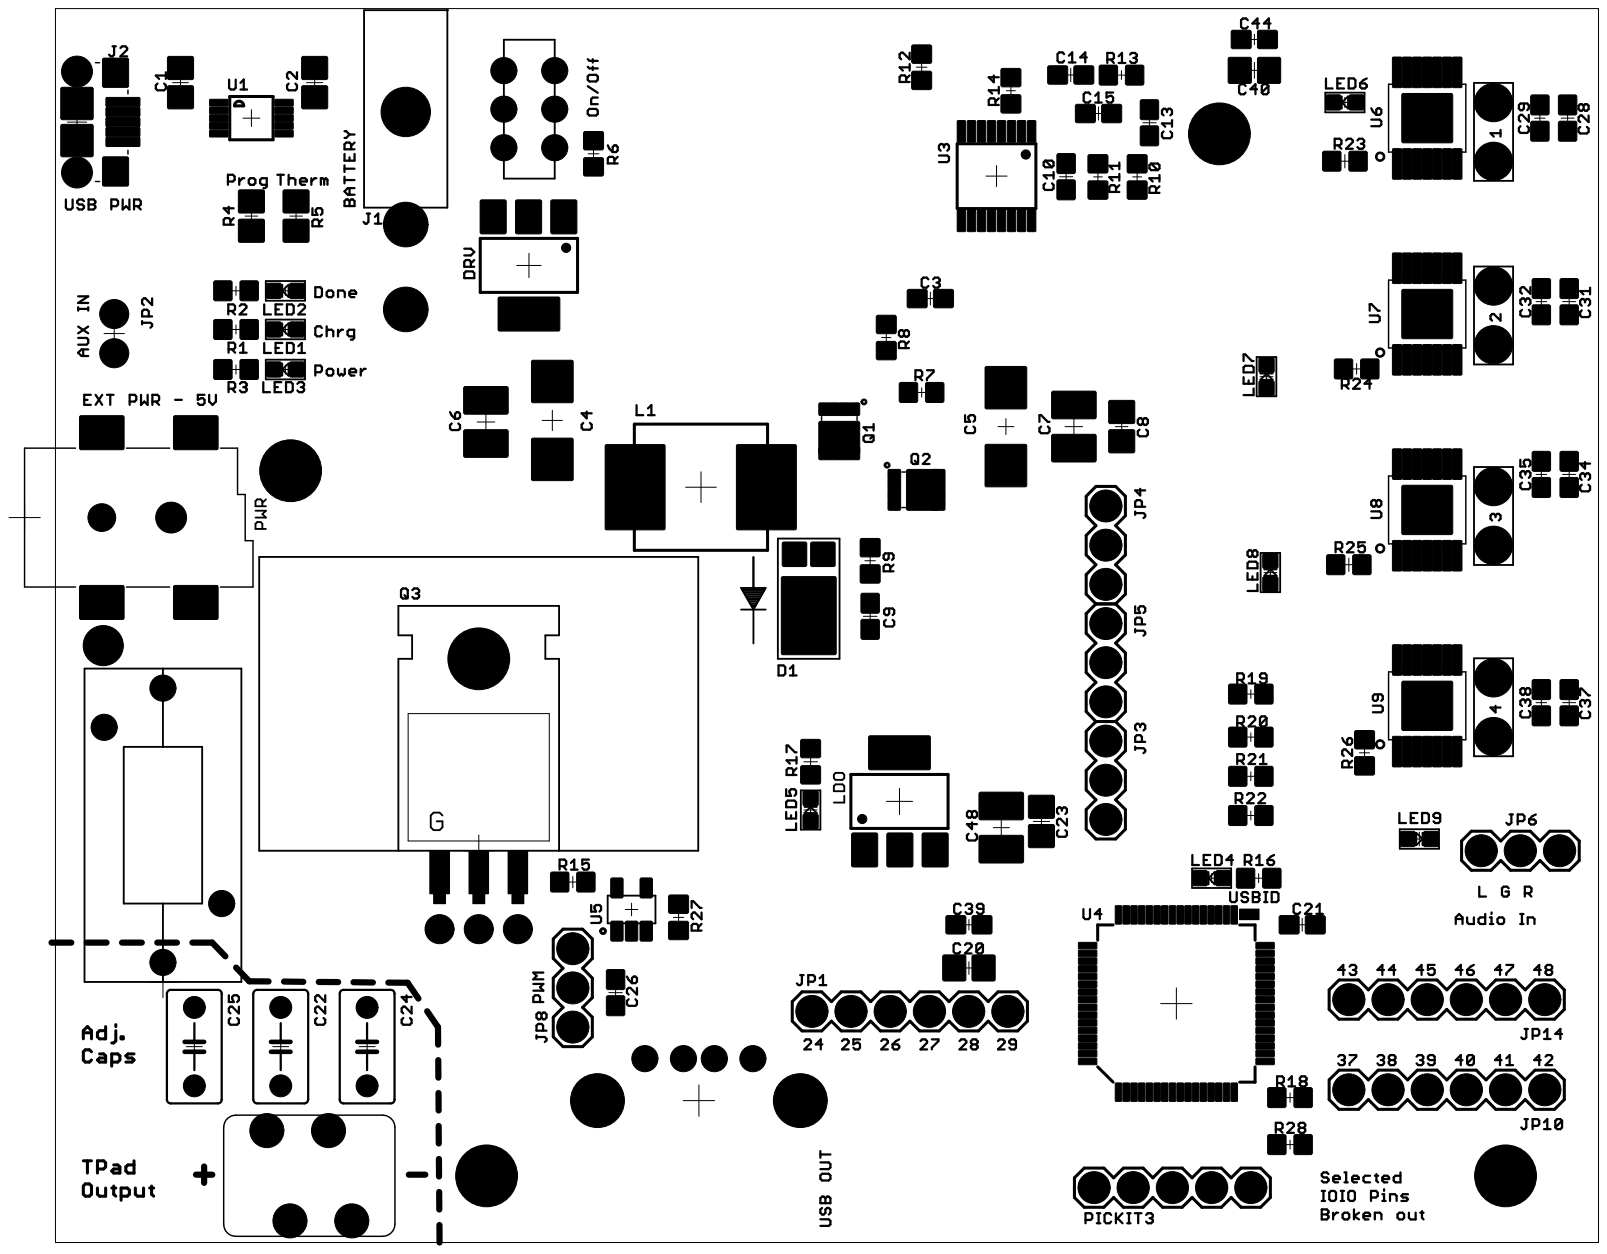
[picture p27: page 1]
