ICST-AHMI/TPadTablet_design/eagle/TPadTabletBattery.brd

## EAGLE design eagle/TPadTabletBattery.brd (2016-03-23)

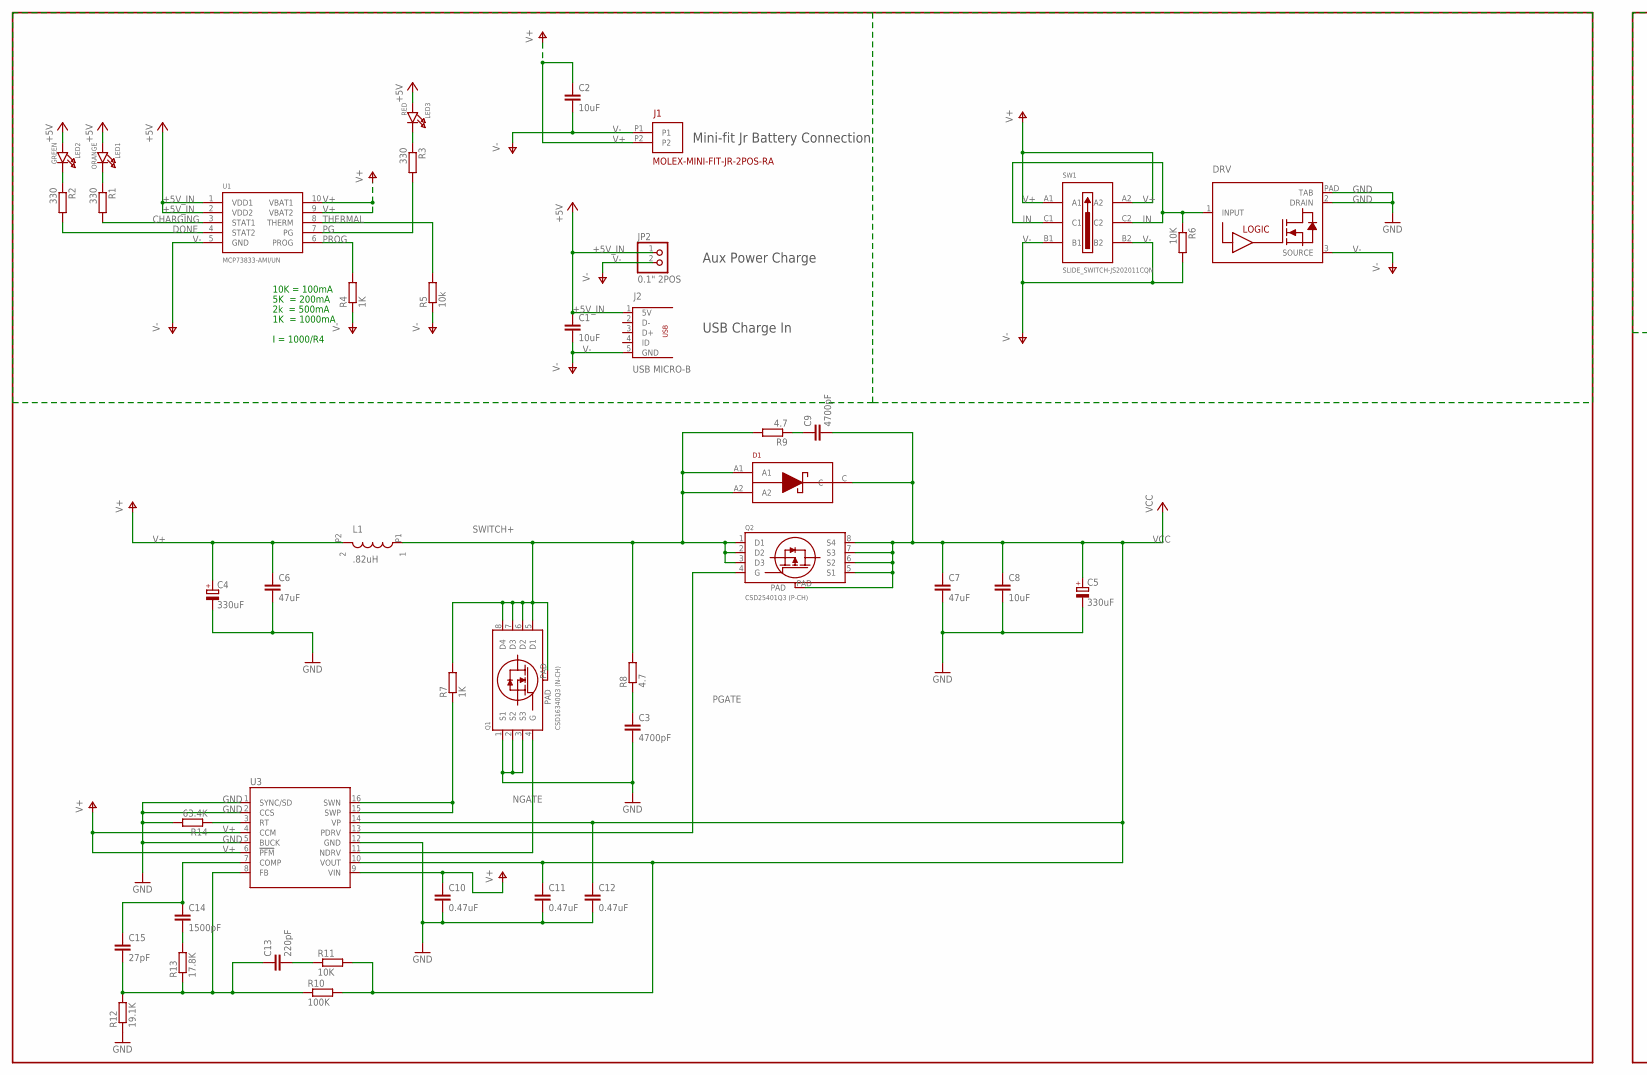
[picture p28: schematic TPadTabletBattery.sch, part in row 1, column 1]

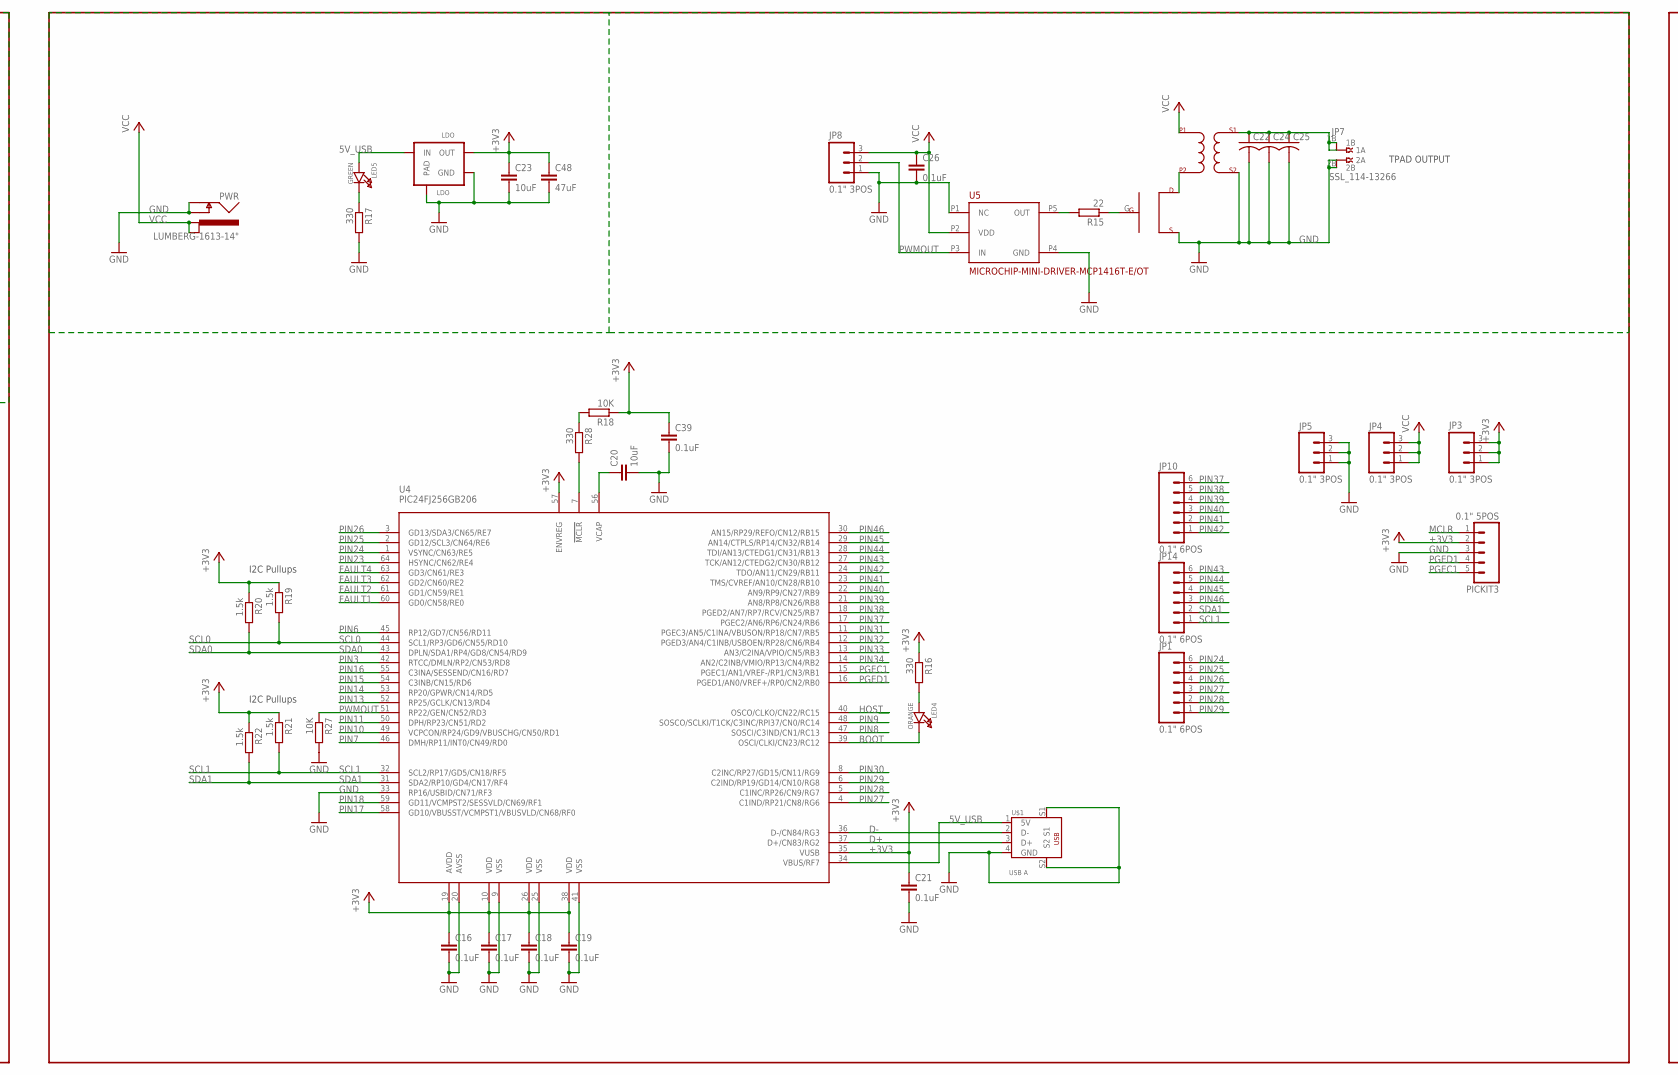
[picture p29: schematic TPadTabletBattery.sch, part in row 1, column 2]

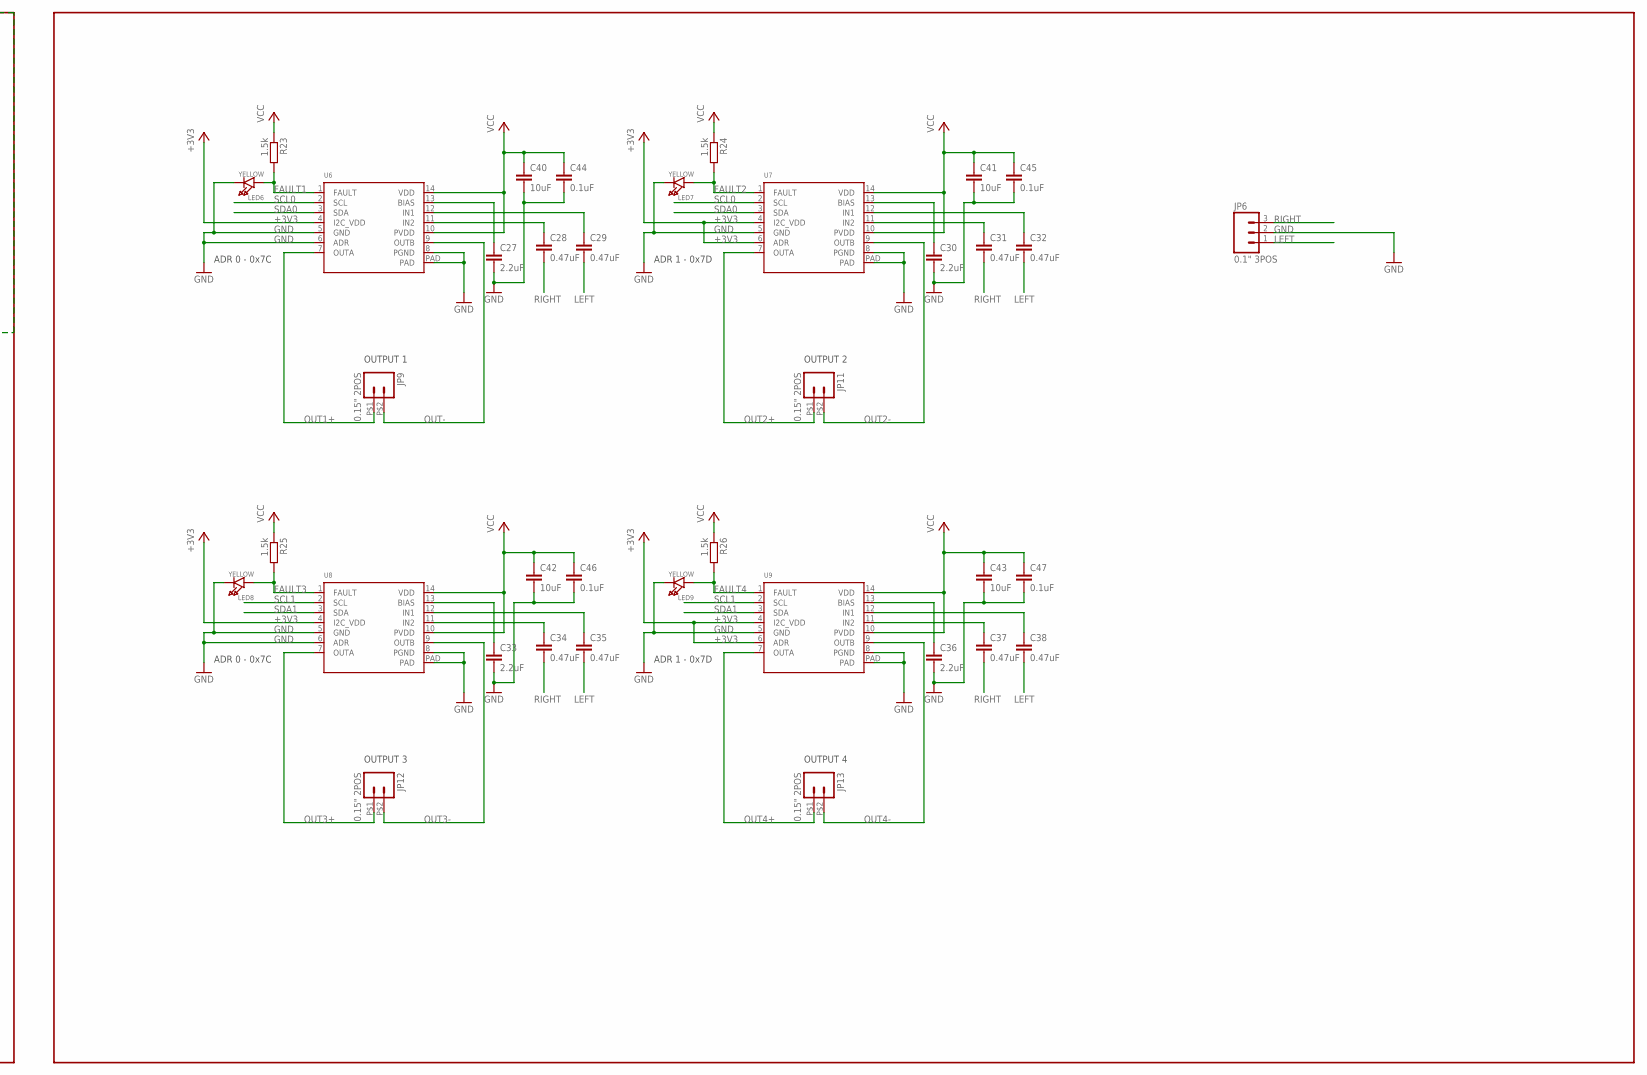
[picture p30: schematic TPadTabletBattery.sch, part in row 1, column 3]

Parts:
C1, C2, C8, C20, C23, C40, C41, C42, C43: 10uF; C0805
C3, C9: 4700pF; C0603
C4, C5: 330uF; C/6032-28R
C6, C7, C48: 47uF; C1210
C10, C11, C12, C28, C29, C31, C32, C34, C35, C37, C38: 0.47uF; C0603
C13: 220pF; C0603
C14: 1500pF; C0603
C15: 27pF; C0603
C16, C17, C18, C19, C21, C26, C39, C44, C45, C46, C47: 0.1uF; C0603
C22, C24, C25: C-US050-035X075; C050-035X075
C27, C30, C33, C36: 2.2uF; C0603
D1: POWER-DIODE_PDS835L
DRV: VLN5050; SOT-223
J1: MOLEX-MINI-FIT-JR-2POS-RA
J2: USB MICRO-B; USB-MICROB_SMD
JP1, JP10, JP14: 0.1" 6POS; 1X06
JP2: 0.1" 2POS; MICROBUILDER_1X02_ROUND
JP3, JP4, JP5, JP6, JP8: 0.1" 3POS; 1X03
JP7: SSL_114-13266
JP9, JP11, JP12, JP13: 0.15" 2POS; 1X02_BIG
L1: .82uH; .82UH_INDUCTOR-IHLP3232DZERR82M01
LDO: LDO; SOT-223
LED1, LED4: ORANGE; MICROBUILDER_CHIPLED_0603
LED2, LED5: GREEN; MICROBUILDER_CHIPLED_0603
LED3: RED; MICROBUILDER_CHIPLED_0603
LED6, LED7, LED8, LED9: YELLOW; MICROBUILDER_CHIPLED_0603
PICKIT3: 0.1" 5POS; 1X05
PWR: LUMBERG-1613-14"; LUMBERG-1613_14
Q1: CSD16340Q3; CSDXXXXQ3
Q2: CSD25401Q3; CSDXXXXQ3
Q3: STP27N3LH5; TPAD_TO220
R1, R2, R3, R16, R17, R28: 330; R0603
R4: 1K; R0805
R5: 10k; R0805
R6, R11, R18, R27: 10K; R0603
R7: 1K; R0603
R8, R9: 4.7; R0603
R10: 100K; R0603
R12: 19.1K; R0603
R13: 17.8K; R0603
R14: 63.4K; R0603
R15: 22; R0603
R19, R20, R21, R22, R23, R24, R25, R26: 1.5k; R0603
SW1: SLIDE_SWITCH-JS202011CQN
U1: MCP73833-AMI/UN; MICROBUILDER_MSOP10
U3: TPS43000; TSSOP16
U4: PIC24FJ256GB206; PIC24FXXX_TQFP64
U5: MICROCHIP-MINI-DRIVER-MCP1416T-E/OT
U6, U7, U8, U9: LM48100Q; LM48100
U$1: USB A; USB-A_SOCKET-THT
U$4: TRANSFORMER

Connections:
5V_USB: LDO.1 (IN), LED5.A, U4.34 (VBUS/RF7), U$1.1 (5V)
+3V3: C16.1, C17.1, C18.1, C19.1, C21.1, C23.1, C39.1, C48.1, JP3.1, JP3.2, JP3.3, LDO.3 (OUT), PICKIT3.2, R16.1, R18.1, R19.1, R20.1, R21.1, R22.1, U4.10 (VDD), U4.19 (AVDD), U4.26 (VDD), U4.35 (VUSB), U4.38 (VDD), U4.57 (ENVREG), U6.4 (I2C_VDD), U7.4 (I2C_VDD), U7.6 (ADR), U8.4 (I2C_VDD), U9.4 (I2C_VDD), U9.6 (ADR)
+5V_IN: C1.1, J2.1 (5V), JP2.1, LED1.A, LED2.A, LED3.A, U1.1 (VDD1), U1.2 (VDD2)
BOOT: LED4.C, U4.39 (OSCI/CLKI/CN23/RC12)
CHARGING: R1.2, U1.3 (STAT1)
D+: U4.37 (D+/CN83/RG2), U$1.3 (D+)
D-: U4.36 (D-/CN84/RG3), U$1.2 (D-)
DONE: R2.2, U1.4 (STAT2)
FAULT1: LED6.A, R23.2, U4.60 (GD0/CN58/RE0), U6.1 (FAULT)
FAULT2: LED7.A, R24.2, U4.61 (GD1/CN59/RE1), U7.1 (FAULT)
FAULT3: LED8.A, R25.2, U4.62 (GD2/CN60/RE2), U8.1 (FAULT)
FAULT4: LED9.A, R26.2, U4.63 (GD3/CN61/RE3), U9.1 (FAULT)
GND: C3.2, C4.-, C5.-, C6.2, C7.2, C8.2, C10.2, C11.2, C12.2, C16.2, C17.2, C18.2, C19.2, C20.2, C21.2, C22.2, C23.2, C24.2, C25.2, C26.2, C27.2, C30.2, C33.2, C36.2, C39.2, C40.2, C41.2, C42.2, C43.2, C44.2, C45.2, C46.2, C47.2, C48.2, DRV.2 (DRAIN), DRV.PAD (TAB), JP5.1, JP5.2, JP5.3, JP6.2, JP7.2A, JP7.2B, JP8.1, LDO.2 (GND), LDO.PAD, LED6.C, LED7.C, LED8.C, LED9.C, PICKIT3.3, PWR.1 (GND), PWR.2 (GND_INS), Q1.1 (S1), Q1.2 (S2), Q1.3 (S3), Q3.S, R12.1, R14.2, R17.2, R27.2, U3.1 (SYNC/SD), U3.2 (CCS), U3.5 (BUCK), U3.12 (GND), U4.9 (VSS), U4.20 (AVSS), U4.25 (VSS), U4.33 (RP16/USBID/CN71/RF3), U4.41 (VSS), U5.P1 (NC), U5.P4 (GND), U6.5 (GND), U6.6 (ADR), U6.8 (PGND), U6.PAD, U7.5 (GND), U7.8 (PGND), U7.PAD, U8.5 (GND), U8.6 (ADR), U8.8 (PGND), U8.PAD, U9.5 (GND), U9.8 (PGND), U9.PAD, U$1.4 (GND), U$1.S1, U$1.S2, U$4.S2
HOST: U4.40 (OSCO/CLKO/CN22/RC15)
IN: DRV.1 (INPUT), R6.1, SW1.C1, SW1.C2
LEFT: C29.2, C32.2, C35.2, C38.2, JP6.1
MCLR: PICKIT3.1, R18.2, R28.1
unnamed: R7.1, U3.15 (SWP), U3.16 (SWN)
unnamed: LED2.C, R2.1
unnamed: LED1.C, R1.1
unnamed: LED3.C, R3.1
unnamed: R28.2, U4.7 (!MCLR)
unnamed: C9.1, R9.1
unnamed: C13.1, C15.2, R10.1, R12.2, R13.1, U3.8 (FB)
unnamed: C14.1, C15.1, U3.7 (COMP)
unnamed: C3.1, R8.1
unnamed: C20.1, U4.56 (VCAP)
unnamed: R14.1, U3.3 (RT)
unnamed: C14.2, R13.2
unnamed: LED4.A, R16.2
unnamed: C13.2, R11.1
unnamed: Q3.D, U$4.P2
unnamed: R15.2, U5.P5 (OUT)
unnamed: C22.1, C24.1, C25.1, JP7.1A, JP7.1B, U$4.S1
unnamed: LED5.C, R17.1
unnamed: Q3.G, R15.1
unnamed: C27.1, U6.13 (BIAS)
unnamed: C29.1, U6.12 (IN1)
unnamed: C28.1, U6.11 (IN2)
unnamed: C30.1, U7.13 (BIAS)
unnamed: C32.1, U7.12 (IN1)
unnamed: C31.1, U7.11 (IN2)
unnamed: C33.1, U8.13 (BIAS)
unnamed: C35.1, U8.12 (IN1)
unnamed: C34.1, U8.11 (IN2)
unnamed: C36.1, U9.13 (BIAS)
unnamed: C38.1, U9.12 (IN1)
unnamed: C37.1, U9.11 (IN2)
NGATE: Q1.4 (G), U3.11 (NDRV)
OUT1+: JP9.P$1 (1), U6.7 (OUTA)
OUT2+: JP11.P$1 (1), U7.7 (OUTA)
OUT2-: JP11.P$2 (2), U7.9 (OUTB)
OUT3+: JP12.P$1 (1), U8.7 (OUTA)
OUT3-: JP12.P$2 (2), U8.9 (OUTB)
OUT4+: JP13.P$1 (1), U9.7 (OUTA)
OUT4-: JP13.P$2 (2), U9.9 (OUTB)
OUT-: JP9.P$2 (2), U6.9 (OUTB)
PG: R3.2, U1.7 (PG)
PGATE: Q2.4 (G), U3.13 (PDRV)
PGEC1: PICKIT3.5, U4.15 (PGEC1/AN1/VREF-/RP1/CN3/RB1)
PGED1: PICKIT3.4, U4.16 (PGED1/AN0/VREF+/RP0/CN2/RB0)
PIN3: U4.42 (RTCC/DMLN/RP2/CN53/RD8)
PIN6: U4.45 (RP12/GD7/CN56/RD11)
PIN7: U4.46 (DMH/RP11/INT0/CN49/RD0)
PIN8: U4.47 (SOSCI/C3IND/CN1/RC13)
PIN9: U4.48 (SOSCO/SCLKI/T1CK/C3INC/RPI37/CN0/RC14)
PIN10: U4.49 (VCPCON/RP24/GD9/VBUSCHG/CN50/RD1)
PIN11: U4.50 (DPH/RP23/CN51/RD2)
PIN13: U4.52 (RP25/GCLK/CN13/RD4)
PIN14: U4.53 (RP20/GPWR/CN14/RD5)
PIN15: U4.54 (C3INB/CN15/RD6)
PIN16: U4.55 (C3INA/SESSEND/CN16/RD7)
PIN17: U4.58 (GD10/VBUSST/VCMPST1/VBUSVLD/CN68/RF0)
PIN18: U4.59 (GD11/VCMPST2/SESSVLD/CN69/RF1)
PIN23: U4.64 (HSYNC/CN62/RE4)
PIN24: JP1.6, U4.1 (VSYNC/CN63/RE5)
PIN25: JP1.5, U4.2 (GD12/SCL3/CN64/RE6)
PIN26: JP1.4, U4.3 (GD13/SDA3/CN65/RE7)
PIN27: JP1.3, U4.4 (C1IND/RP21/CN8/RG6)
PIN28: JP1.2, U4.5 (C1INC/RP26/CN9/RG7)
PIN29: JP1.1, U4.6 (C2IND/RP19/GD14/CN10/RG8)
PIN30: U4.8 (C2INC/RP27/GD15/CN11/RG9)
PIN31: U4.11 (PGEC3/AN5/C1INA/VBUSON/RP18/CN7/RB5)
PIN32: U4.12 (PGED3/AN4/C1INB/USBOEN/RP28/CN6/RB4)
PIN33: U4.13 (AN3/C2INA/VPIO/CN5/RB3)
PIN34: U4.14 (AN2/C2INB/VMIO/RP13/CN4/RB2)
PIN37: JP10.6, U4.17 (PGEC2/AN6/RP6/CN24/RB6)
PIN38: JP10.5, U4.18 (PGED2/AN7/RP7/RCV/CN25/RB7)
PIN39: JP10.4, U4.21 (AN8/RP8/CN26/RB8)
PIN40: JP10.3, U4.22 (AN9/RP9/CN27/RB9)
PIN41: JP10.2, U4.23 (TMS/CVREF/AN10/CN28/RB10)
PIN42: JP10.1, U4.24 (TDO/AN11/CN29/RB11)
PIN43: JP14.6, U4.27 (TCK/AN12/CTEDG2/CN30/RB12)
PIN44: JP14.5, U4.28 (TDI/AN13/CTEDG1/CN31/RB13)
PIN45: JP14.4, U4.29 (AN14/CTPLS/RP14/CN32/RB14)
PIN46: JP14.3, U4.30 (AN15/RP29/REFO/CN12/RB15)
PROG: R4.2, U1.6 (PROG)
PWMOUT: JP8.2, R27.1, U4.51 (RP22/GEN/CN52/RD3), U5.P3 (IN)
RIGHT: C28.2, C31.2, C34.2, C37.2, JP6.3
SCL0: R19.2, U4.44 (SCL1/RP3/GD6/CN55/RD10), U6.2 (SCL), U7.2 (SCL)
SCL1: JP14.1, R21.2, U4.32 (SCL2/RP17/GD5/CN18/RF5), U8.2 (SCL), U9.2 (SCL)
SDA0: R20.2, U4.43 (DPLN/SDA1/RP4/GD8/CN54/RD9), U6.3 (SDA), U7.3 (SDA)
SDA1: JP14.2, R22.2, U4.31 (SDA2/RP10/GD4/CN17/RF4), U8.3 (SDA), U9.3 (SDA)
SWITCH+: D1.A1, D1.A2, L1.P1 (1), Q1.5 (D1), Q1.6 (D2), Q1.7 (D3), Q1.8 (D4), Q1.PAD, Q2.1 (D1), Q2.2 (D2), Q2.3 (D3), R7.2, R8.2, R9.2
THERMAL: R5.2, U1.8 (THERM)
V+: C2.1, C4.+, C6.1, C10.1, J1.P2, L1.P2 (2), SW1.A1, SW1.A2, U1.9 (VBAT2), U1.10 (VBAT1), U3.4 (CCM), U3.6 (!PFM), U3.9 (VIN)
V-: C1.2, C2.2, DRV.3 (SOURCE), J1.P1, J2.5 (GND), JP2.2, R4.1, R5.1, R6.2, SW1.B1, SW1.B2, U1.5 (GND)
VCC: C5.+, C7.1, C8.1, C9.2, C11.1, C12.1, C26.1, C40.1, C41.1, C42.1, C43.1, C44.1, C45.1, C46.1, C47.1, D1.C, JP4.1, JP4.2, JP4.3, JP8.3, PWR.3 (PWR_1), PWR.4 (PWR_2), Q2.5 (S1), Q2.6 (S2), Q2.7 (S3), Q2.8 (S4), Q2.PAD, R10.2, R11.2, R23.1, R24.1, R25.1, R26.1, U3.10 (VOUT), U3.14 (VP), U5.P2 (VDD), U6.10 (PVDD), U6.14 (VDD), U7.10 (PVDD), U7.14 (VDD), U8.10 (PVDD), U8.14 (VDD), U9.10 (PVDD), U9.14 (VDD), U$4.P1

Notes on the sheet:
10K = 100mA
5K = 200mA
2k = 500mA
1K = 1000mA
I = 1000/R4
Mini-fit Jr Battery Connection
USB Charge In
Aux Power Charge
ADR 0 - 0x7C
I2C Pullups
OUTPUT 1
TPAD OUTPUT
OUTPUT 2
ADR 1 - 0x7D
OUTPUT 3
OUTPUT 4

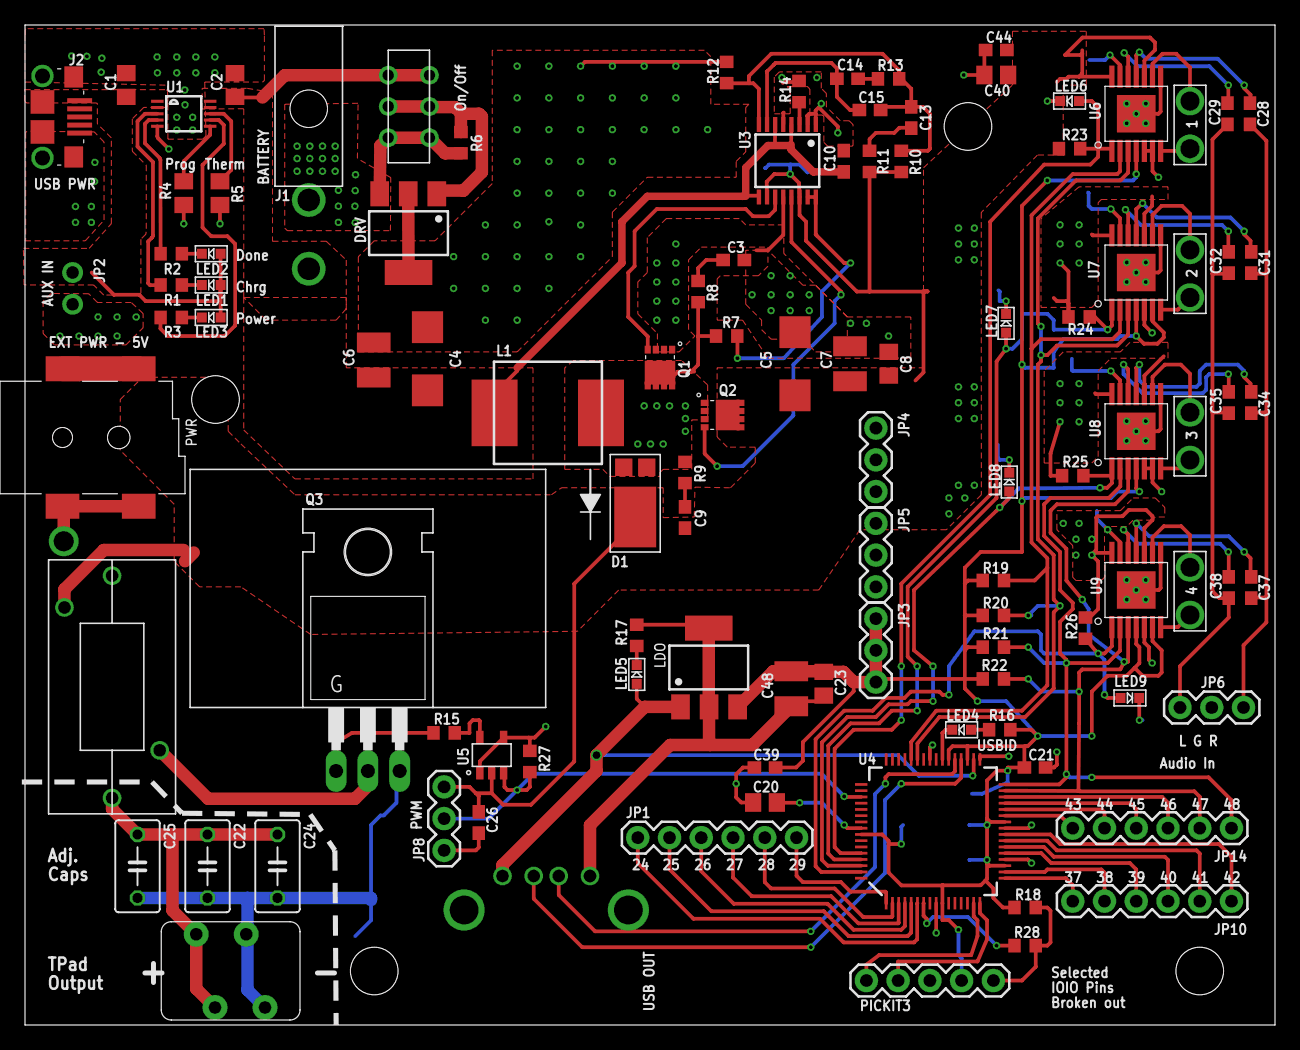
[picture p31: board TPadTabletBattery.brd from above]

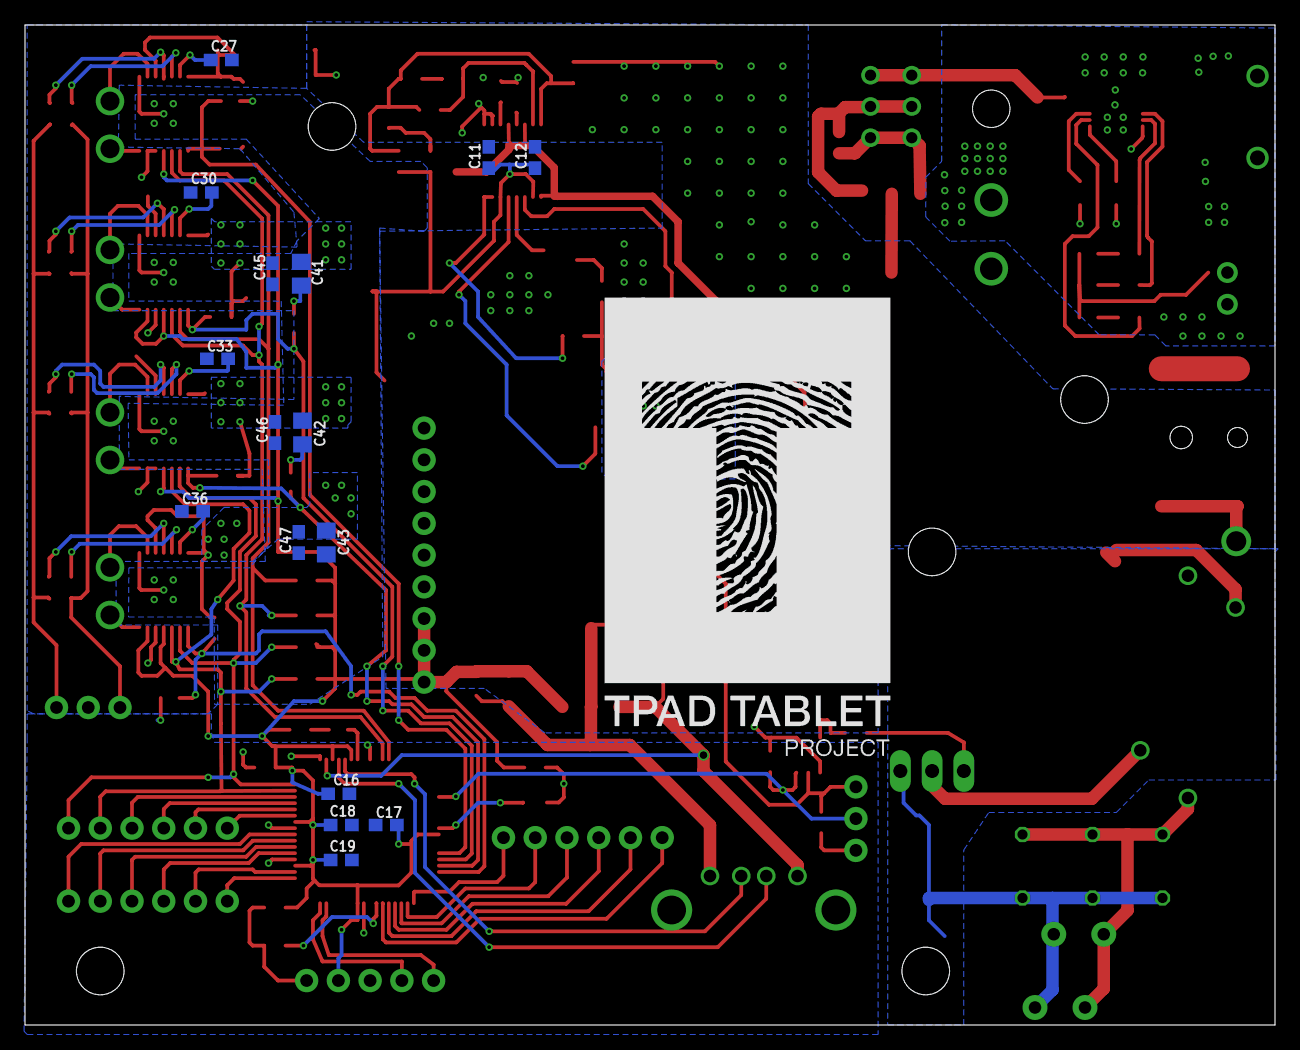
[picture p32: board TPadTabletBattery.brd from below]

Board: 2 copper layers, 100.0 x 80.0 mm, 122 parts (17 on the bottom side), 88 nets.

Other parts of the board:
LOGO: TPADTABLETPROJECT
